ssavazzi02/tinyProbe_wius/3d_model/ASMPM-0806-2R2M-T.STEP

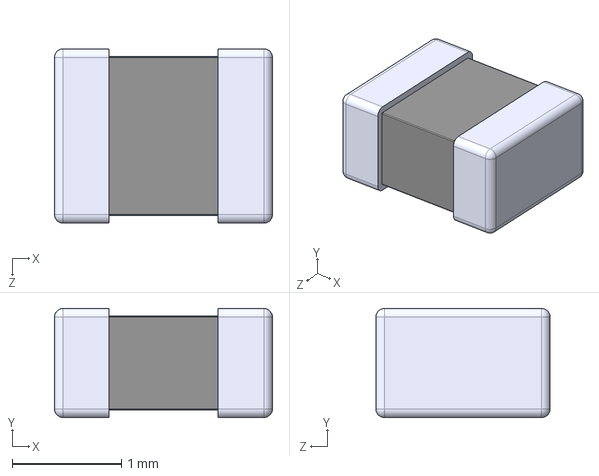
[picture p1: CAD file, 2026-06-25]
3d_model/ASMPM-0806-2R2M-T.STEP
2.00 x 1.00 x 1.60 mm
