ssavazzi02/tinyProbe_wius/3d_model/MSOP8_MC_MCH.step

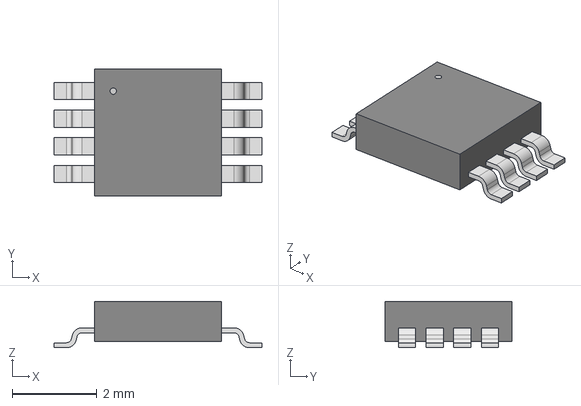
[picture p2: CAD file, 2026-08-20]
3d_model/MSOP8_MC_MCH.step
4.90 x 3.00 x 1.09 mm
