ssavazzi02/tinyProbe_wius/3d_model/ASCO-12.000MHZ-EK-T3.stp

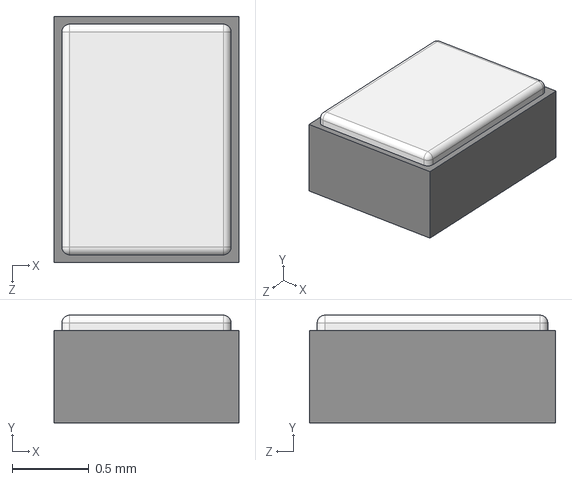
[picture p3: CAD file, 2026-08-20]
3d_model/ASCO-12.000MHZ-EK-T3.stp
1.20 x 0.7 x 1.60 mm
