ssavazzi02/tinyProbe_wius/3d_model/SIT1552AI-JE-DCC-32.768E.stp

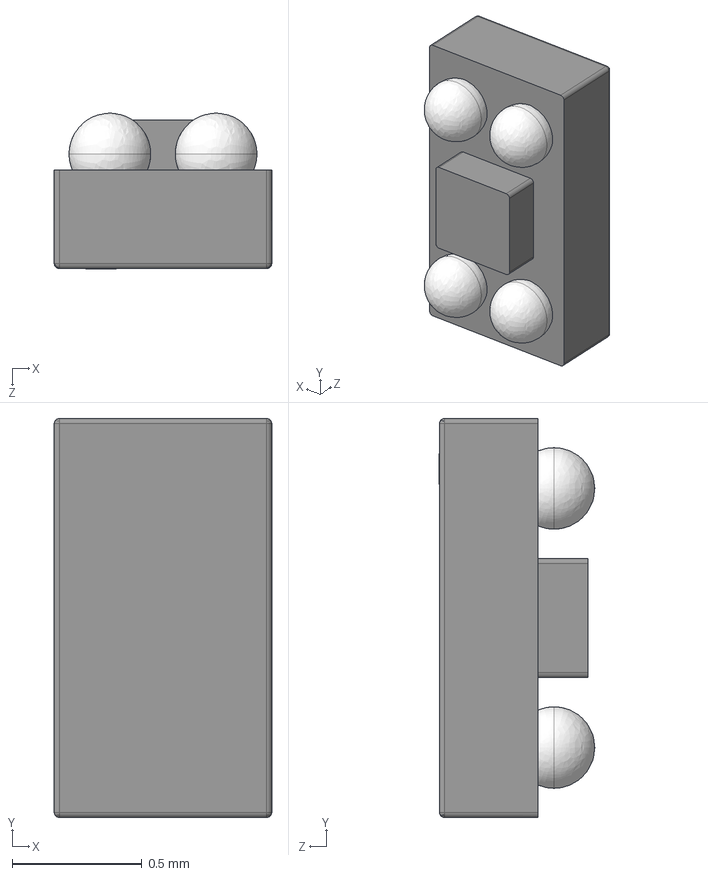
[picture p4: CAD file, 2026-06-25]
3d_model/SIT1552AI-JE-DCC-32.768E.stp
0.84 x 1.54 x 0.601 mm
Pin1_Dot
