ssavazzi02/tinyProbe_wius/3d_model/SS5-10-3.00-L-D-K-TR.stp

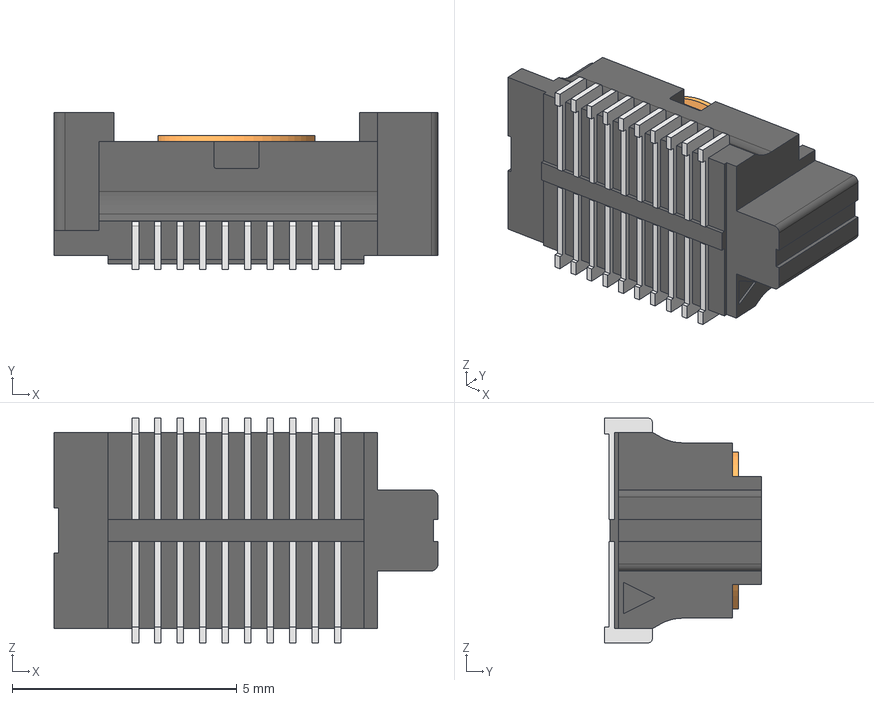
[picture p5: CAD file, 2026-06-25]
3d_model/SS5-10-3.00-L-D-K-TR.stp
8.54 x 3.50 x 5.00 mm
SS5-10_socket
C-229-10-3.00_
C-229-10-3.00-2_
K-DOT-.138-.250-.005_polyamide_pick_
