ssavazzi02/tinyProbe_wius/3d_model/SM02B-SURS-TF (LF)(SN)--3DModel-STEP-510211.STEP

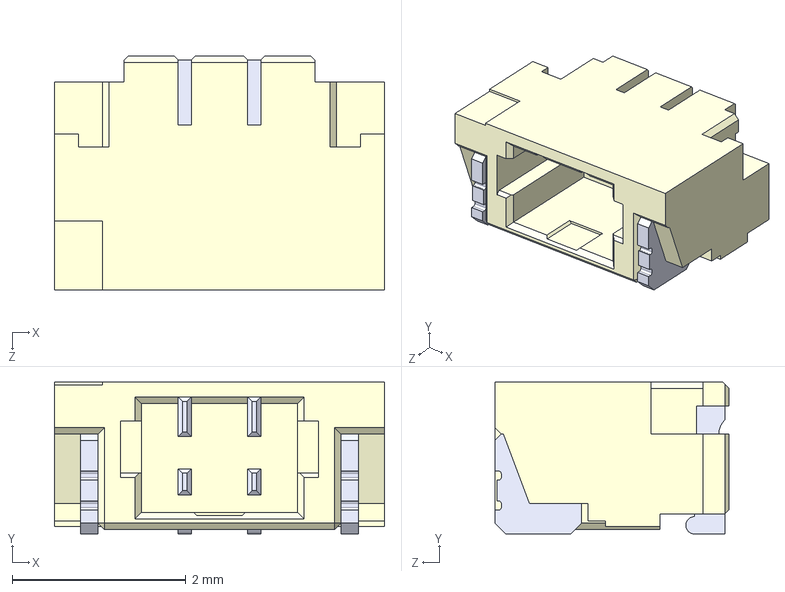
[picture p6: CAD file, 2026-06-25]
3d_model/SM02B-SURS-TF (LF)(SN)--3DModel-STEP-510211.STEP
3.80 x 1.75 x 2.70 mm
