ssavazzi02/tinyProbe_wius/3d_model/XTAL_KC2016K32_7680C1GE00_KAV.step

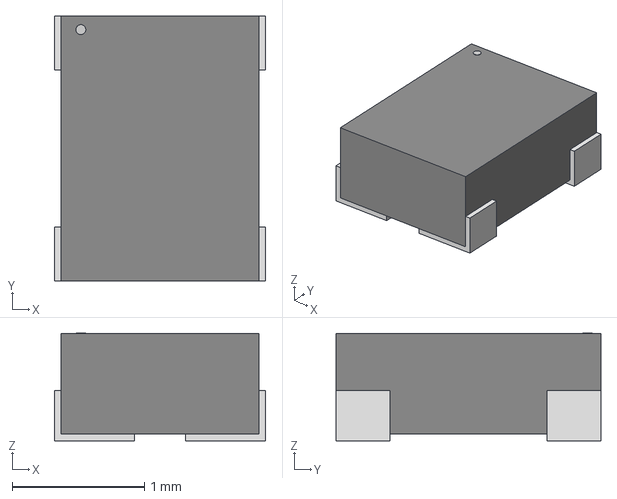
[picture p7: CAD file, 2026-06-25]
3d_model/XTAL_KC2016K32_7680C1GE00_KAV.step
1.60 x 2.01 x 0.815 mm
