ssavazzi02/tinyProbe_wius/3d_model/SIWG917Y111MGABAR.stp

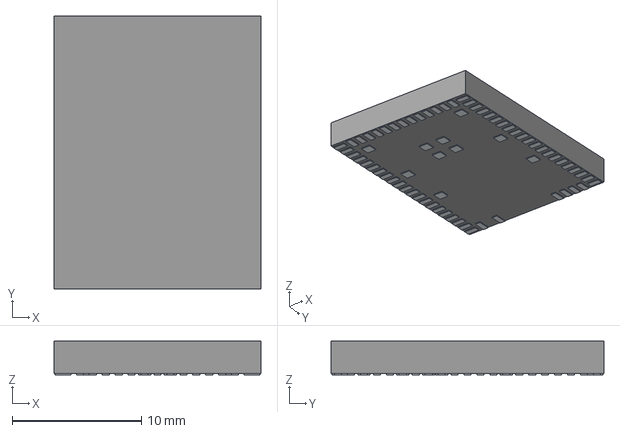
[picture p8: CAD file, 2026-06-25]
3d_model/SIWG917Y111MGABAR.stp
16.0 x 21.1 x 2.60 mm
Pins
