ssavazzi02/tinyProbe_wius/3d_model/QFN-56_FT232HPQ_FTD.step

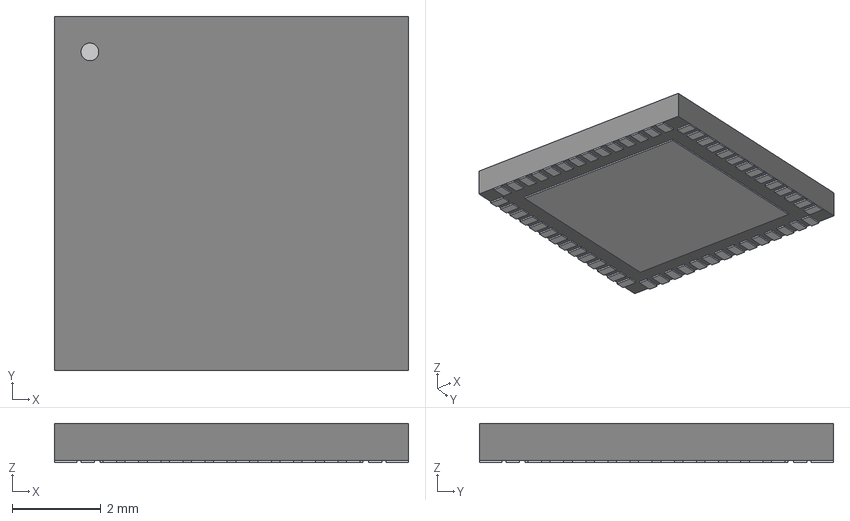
[picture p9: CAD file, 2026-06-25]
3d_model/QFN-56_FT232HPQ_FTD.step
8.00 x 8.00 x 0.892 mm
