ssavazzi02/tinyProbe_wius/3d_model/PCAL6408AHKX.stp

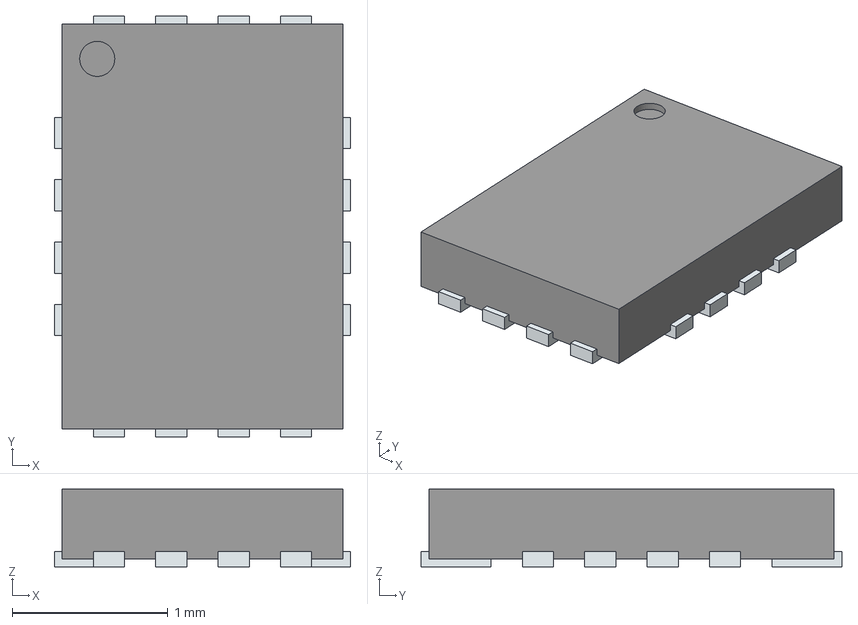
[picture p10: CAD file, 2026-06-11]
3d_model/PCAL6408AHKX.stp
1.90 x 2.70 x 0.5 mm
PinsArrayLR
PinsArrayTB
