ssavazzi02/tinyProbe_wius/3d_model/104031-0811.stp

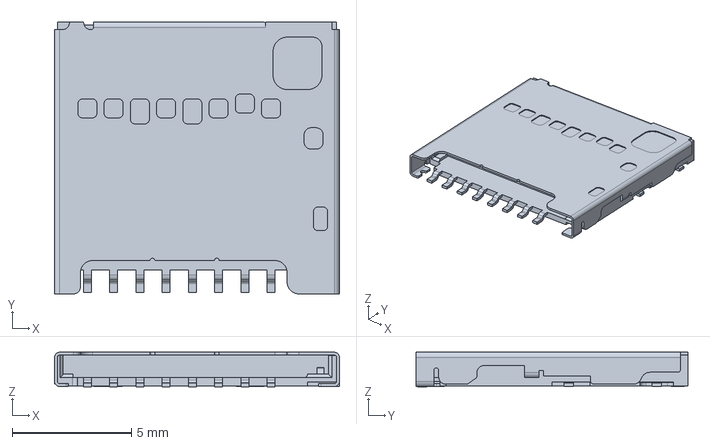
[picture p11: CAD file, 2026-06-25]
3d_model/104031-0811.stp
11.9 x 11.4 x 1.45 mm
