ssavazzi02/tinyProbe_wius/3d_model/TPS62840YBGR--3DModel-STEP-56544.STEP

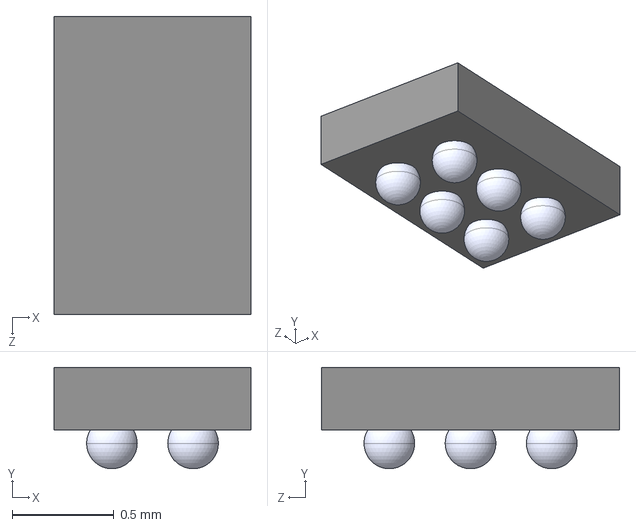
[picture p12: CAD file, 2026-06-25]
3d_model/TPS62840YBGR--3DModel-STEP-56544.STEP
0.968 x 0.5 x 1.47 mm
