ssavazzi02/tinyProbe_wius/3d_model/BQ24040DSQT.stp

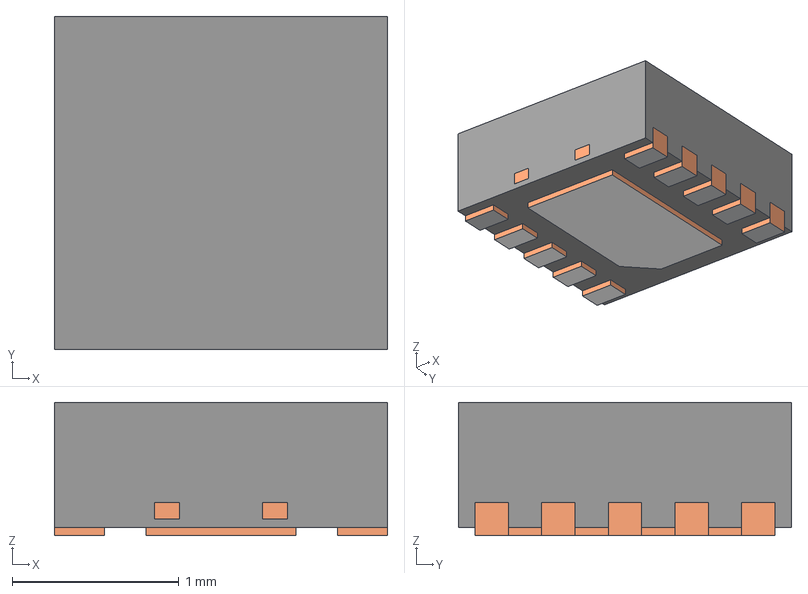
[picture p13: CAD file, 2026-06-25]
3d_model/BQ24040DSQT.stp
2.00 x 2.00 x 0.8 mm
BODY-SON
FRAME-DSQ0010A
PIN1-ID
