ssavazzi02/tinyProbe_wius/3d_model/5051100892.stp

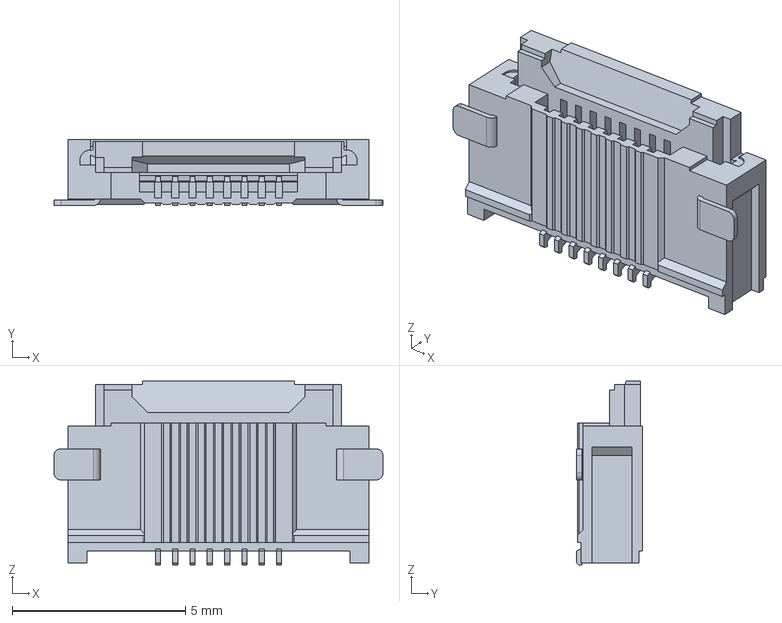
[picture p14: CAD file, 2026-06-25]
3d_model/5051100892.stp
9.50 x 1.90 x 5.30 mm
