ssavazzi02/tinyProbe_wius/3d_model/52746-1271.stp

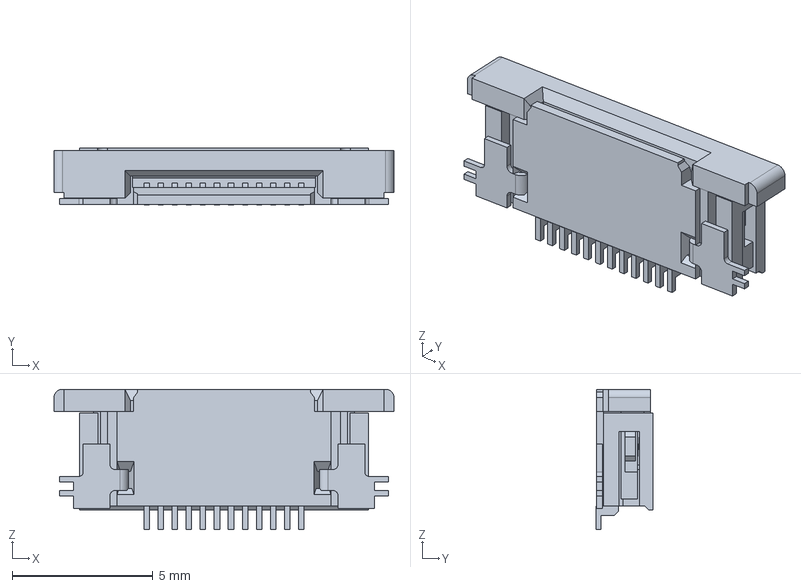
[picture p15: CAD file, 2026-06-25]
3d_model/52746-1271.stp
12.1 x 2.02 x 5.00 mm
