ssavazzi02/tinyProbe_wius/wius_new.pdf

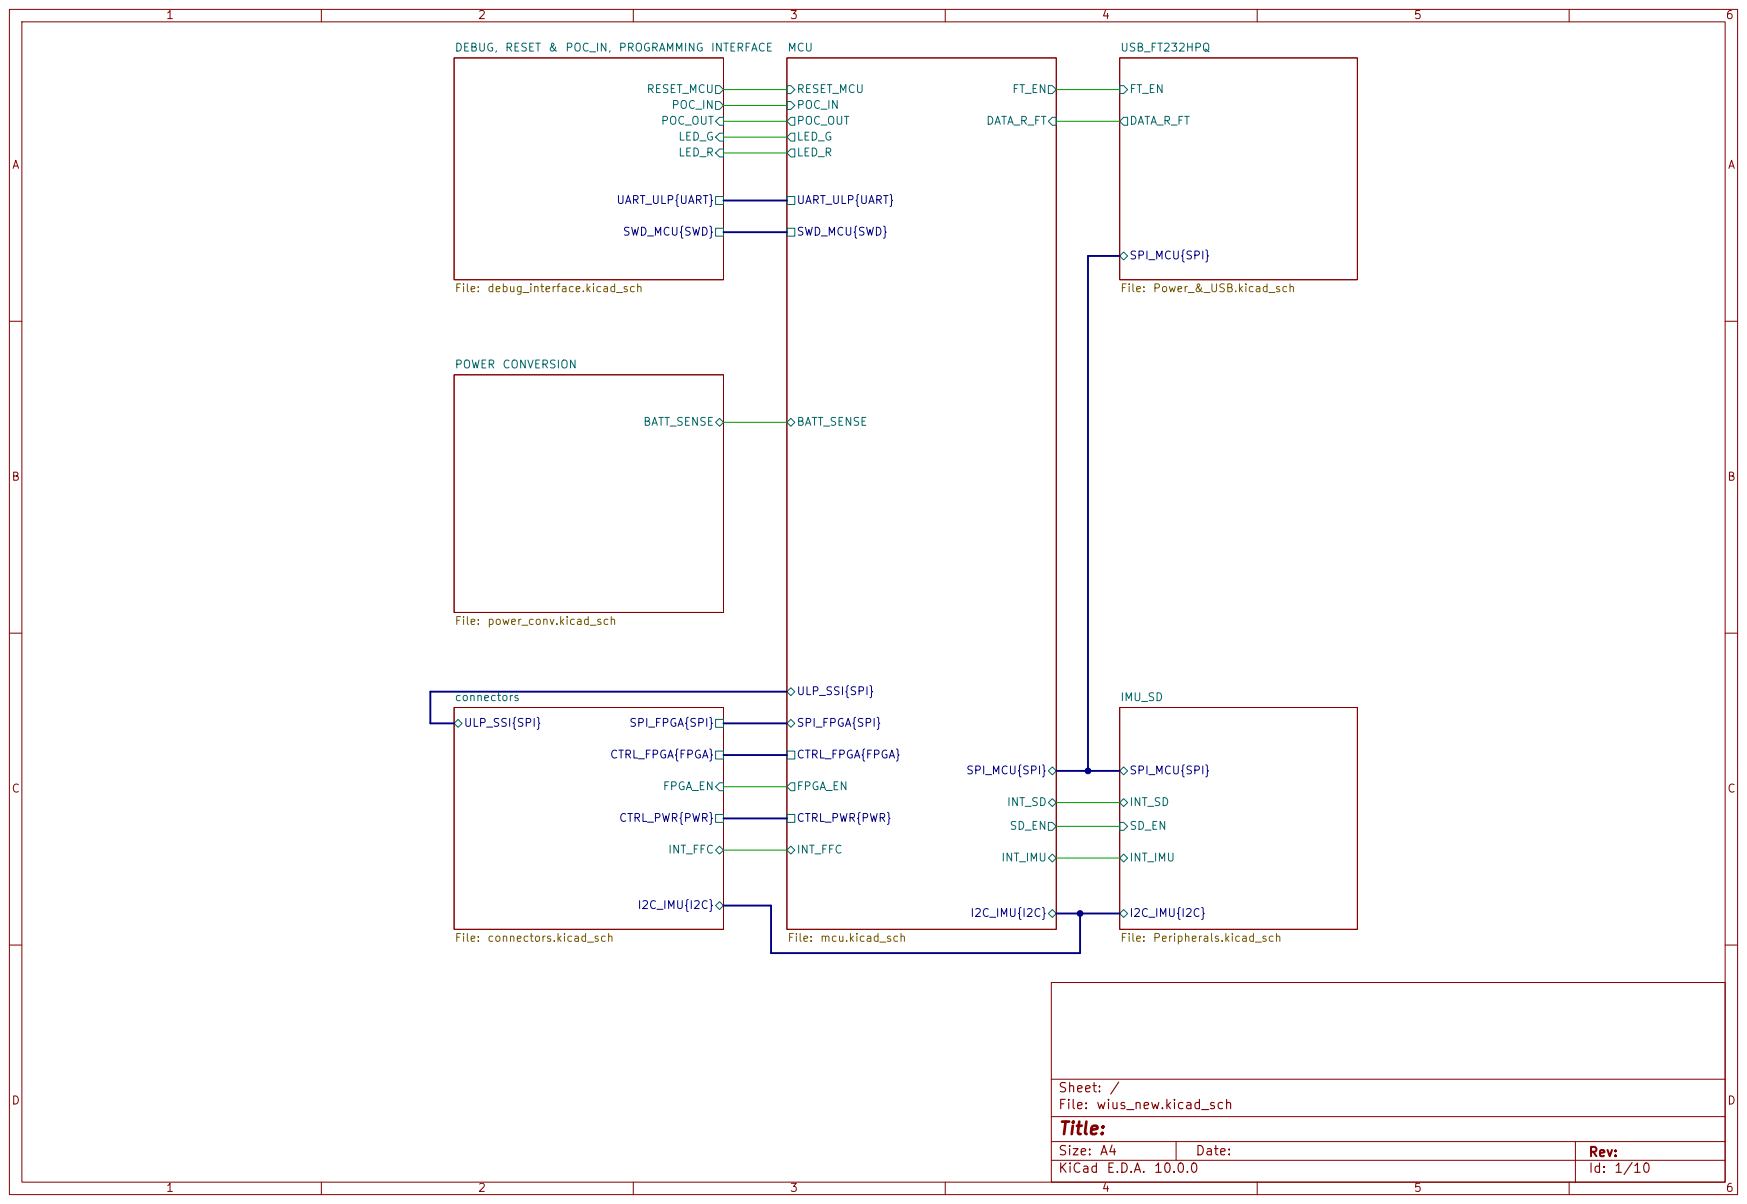
[picture p16: page 1]

DEBUG, RESET & POC_IN, PROGRAMMING INTERFACE

Size: A4 | Rev:
KiCad E.D.A. 10.0.0 | Id: 1/10

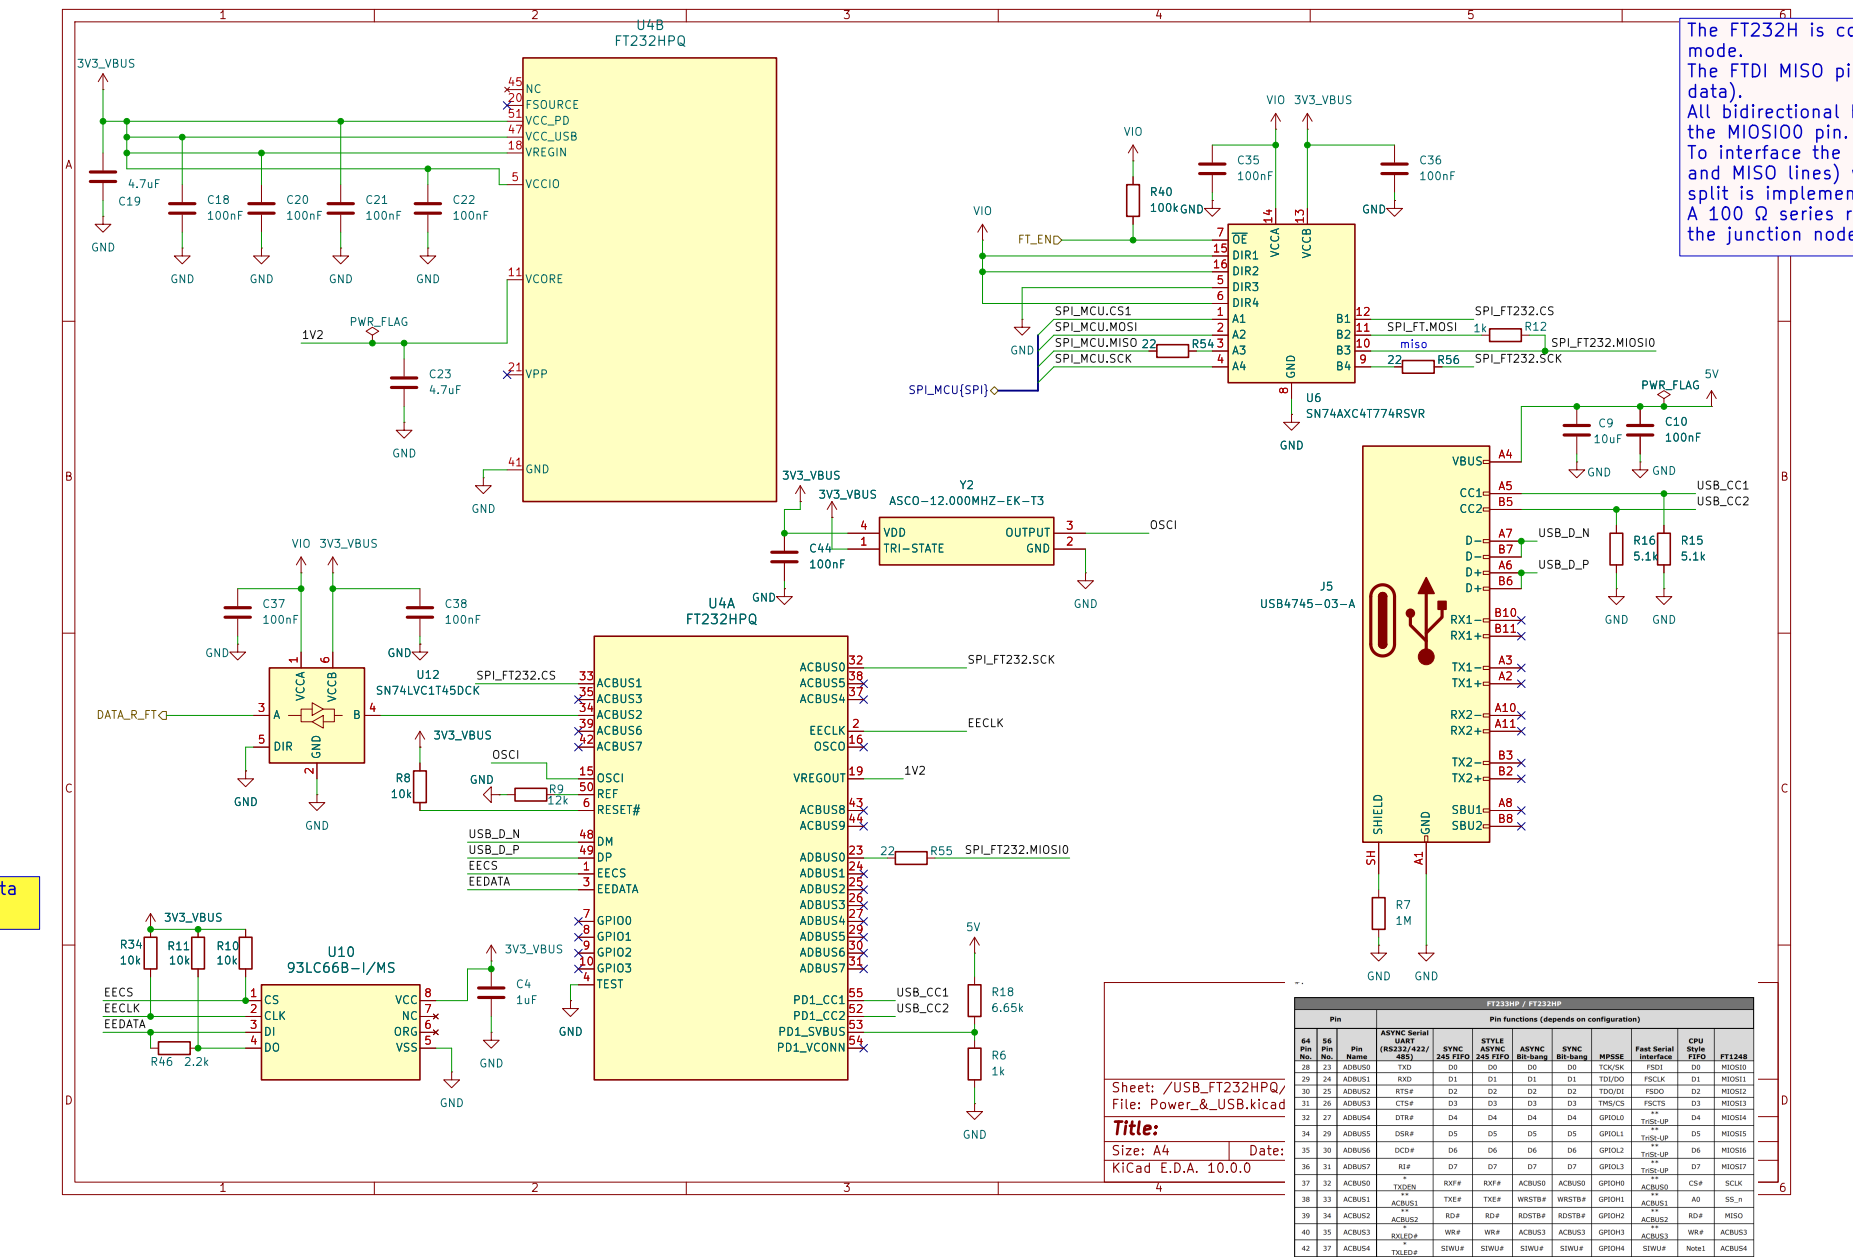
[picture p17: page 2]

mode.
The FTDI MISO pin is not used in this mode (jsut for state
data).
All bidirectional half-duplex data traffic is carried over
the MIOSIO0 pin.
To interface the MCU's standard SPI bus (separate MOSI
and MISO lines) with the single MIOSIO0 pin, the signal
split is implemented on the 3.3 V side (TXB0104 output).
A 100 Ω series resistor is placed on the MOSI line before
the junction node with MISO.

VREGIN 18

VCCIO 5

ATTACH ACBUS5 to MCU for "data

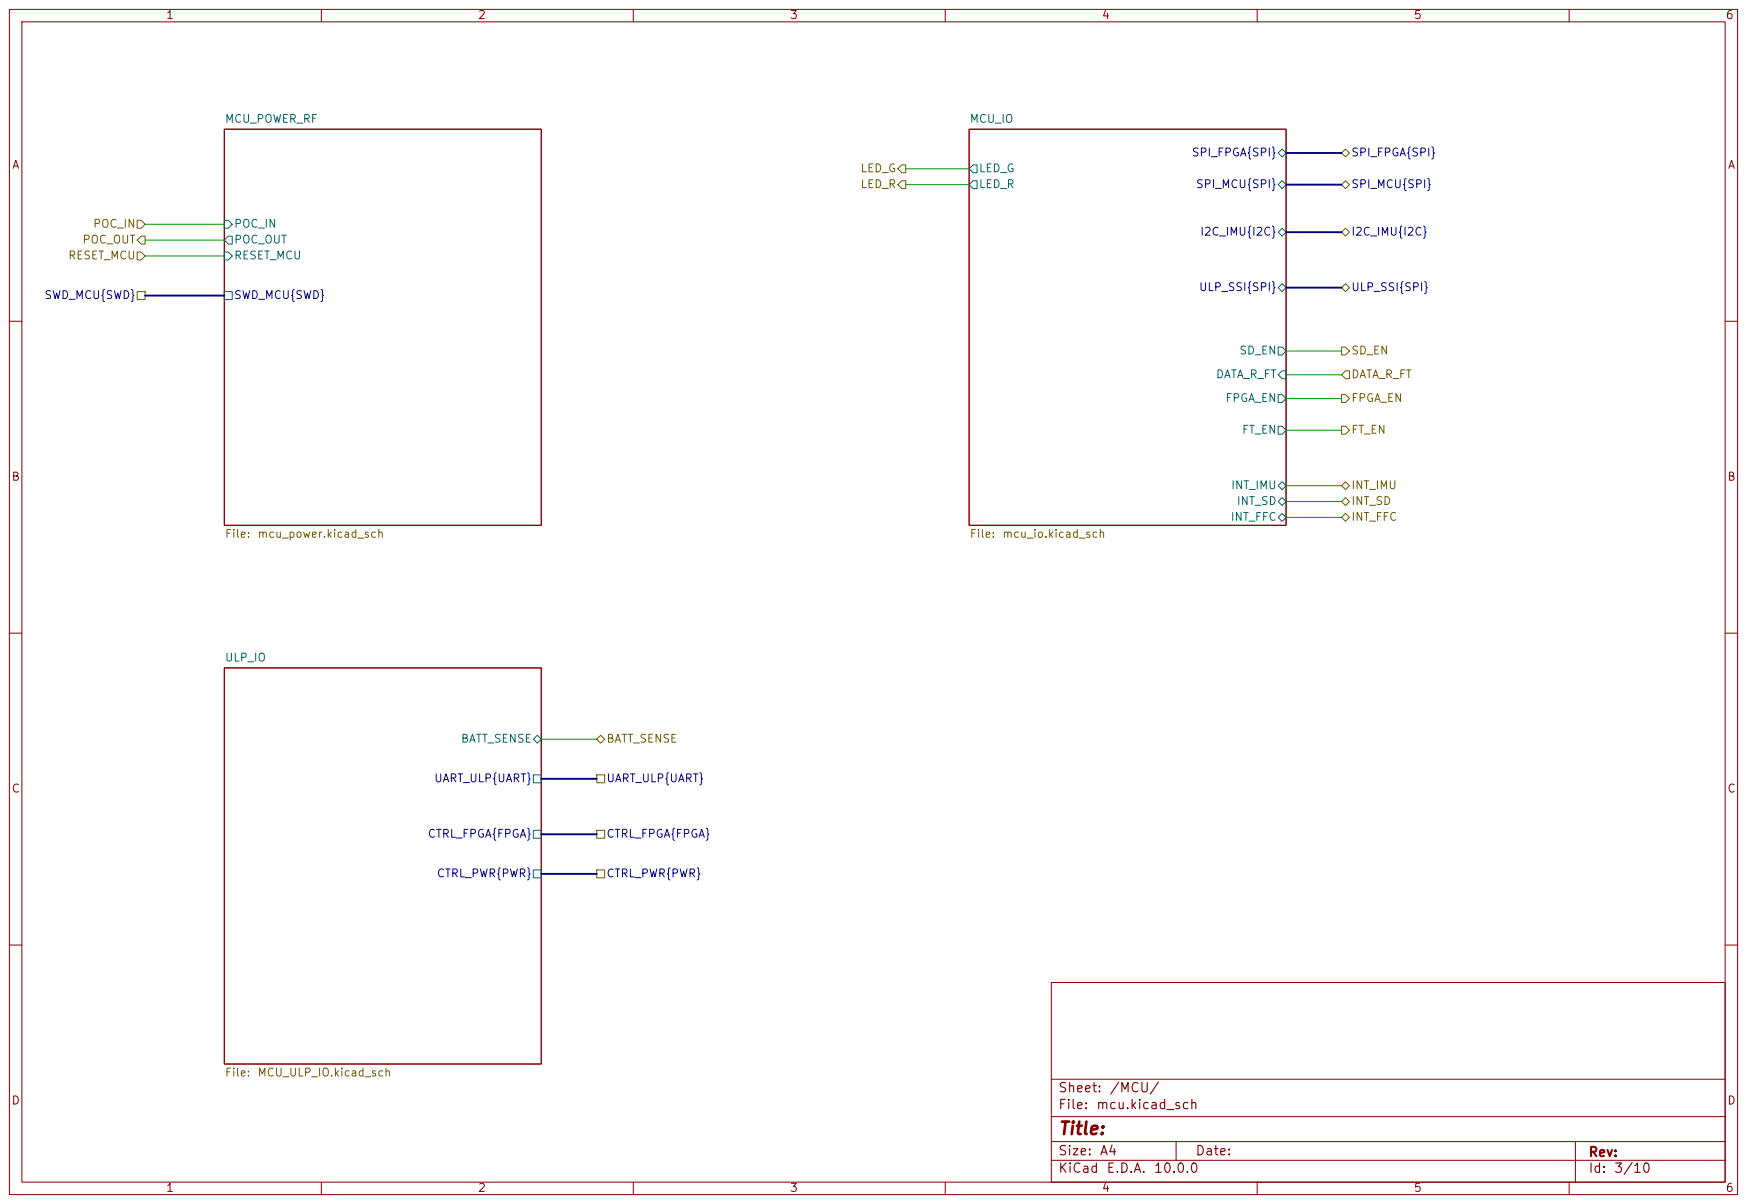
[picture p18: page 3]

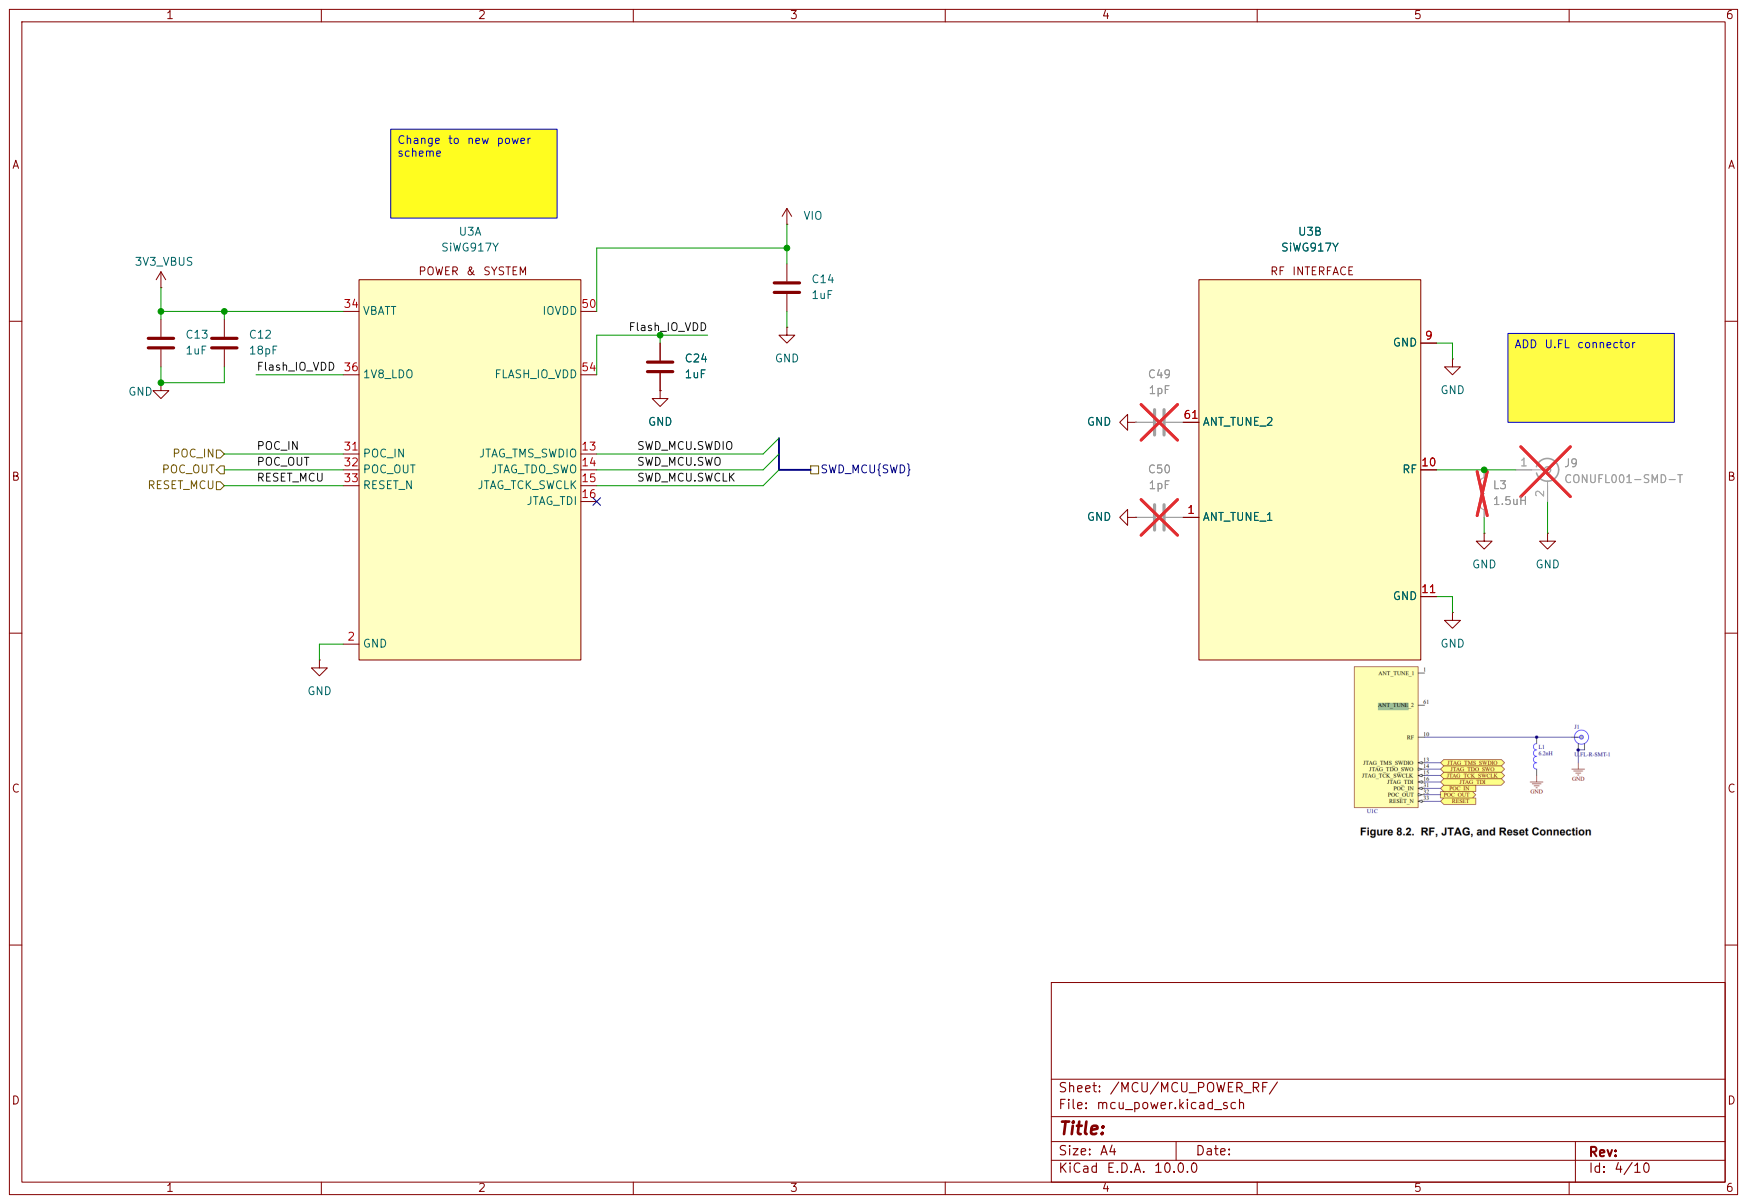
[picture p19: page 4]

ADD U.FL connector Change to new power scheme

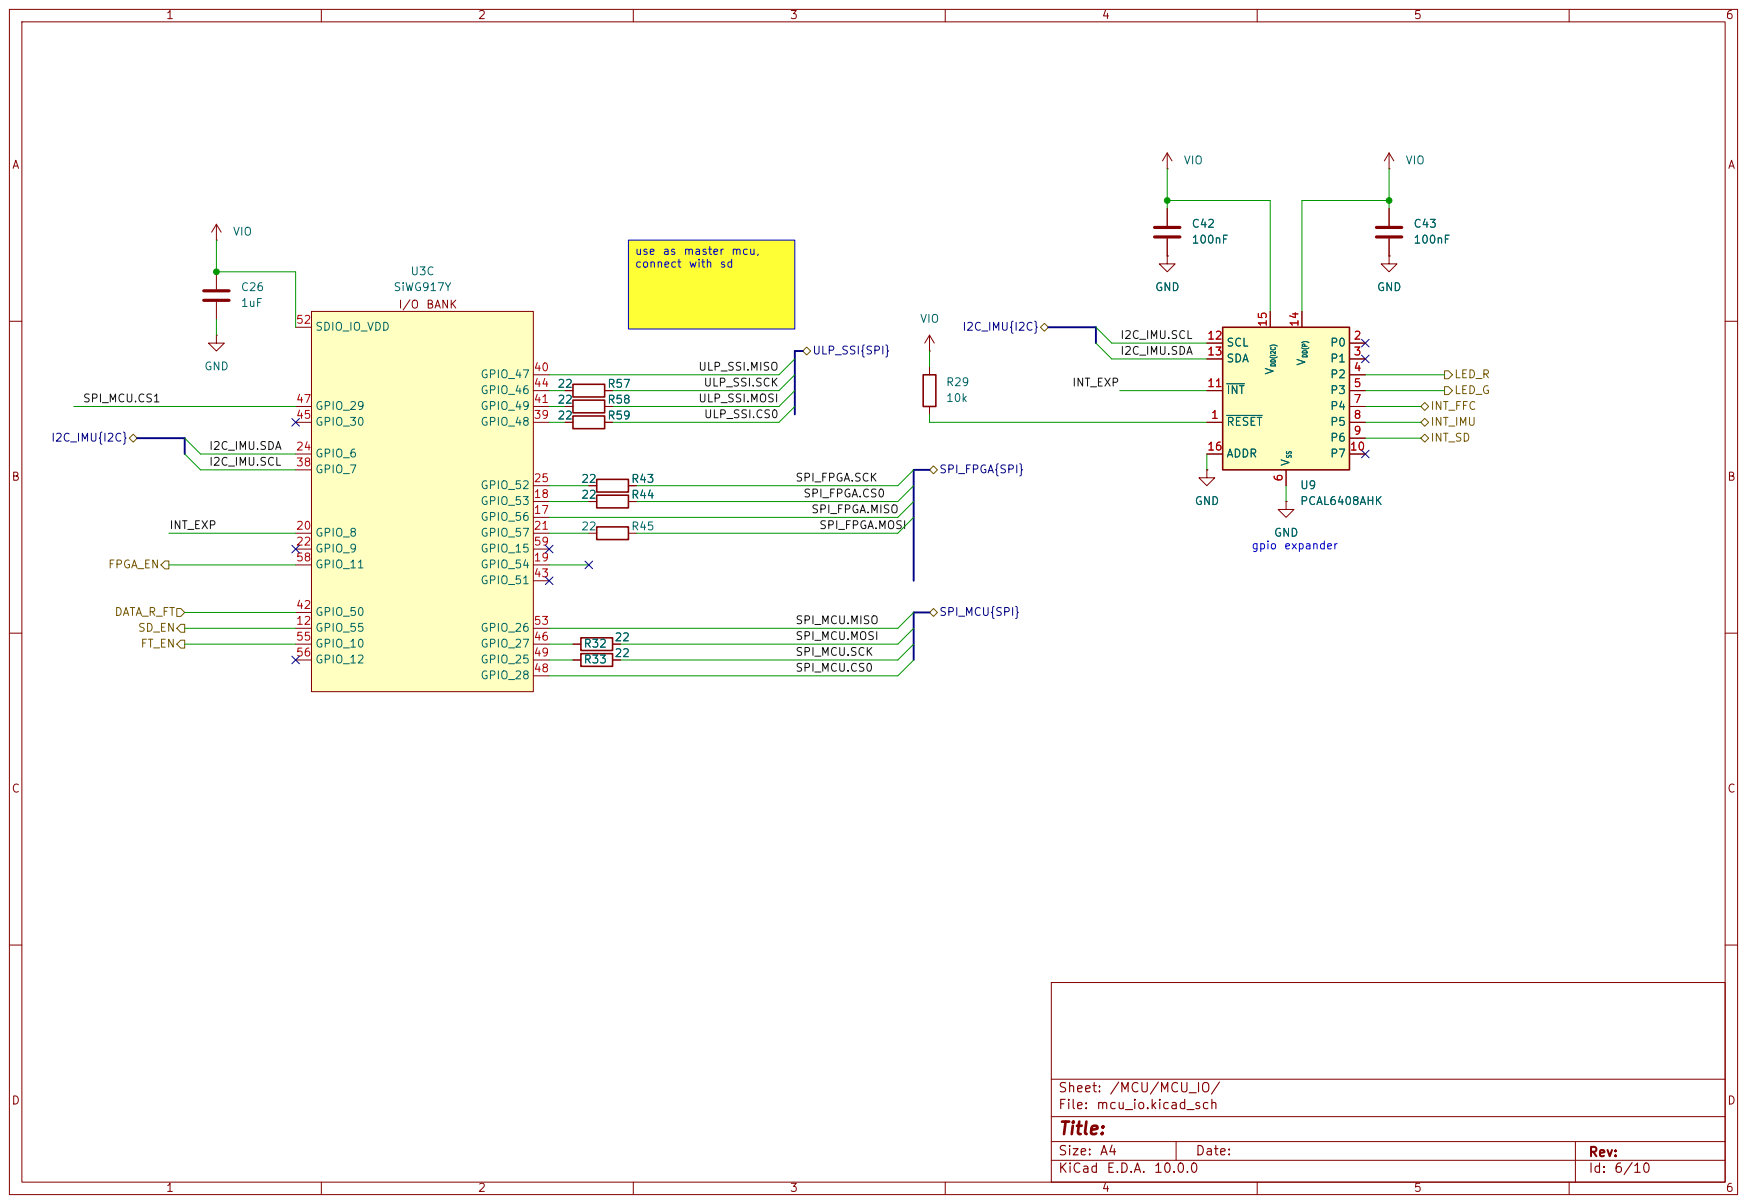
[picture p20: page 5]

SPI_MCU.MOSI use as master mcu, connect with sd

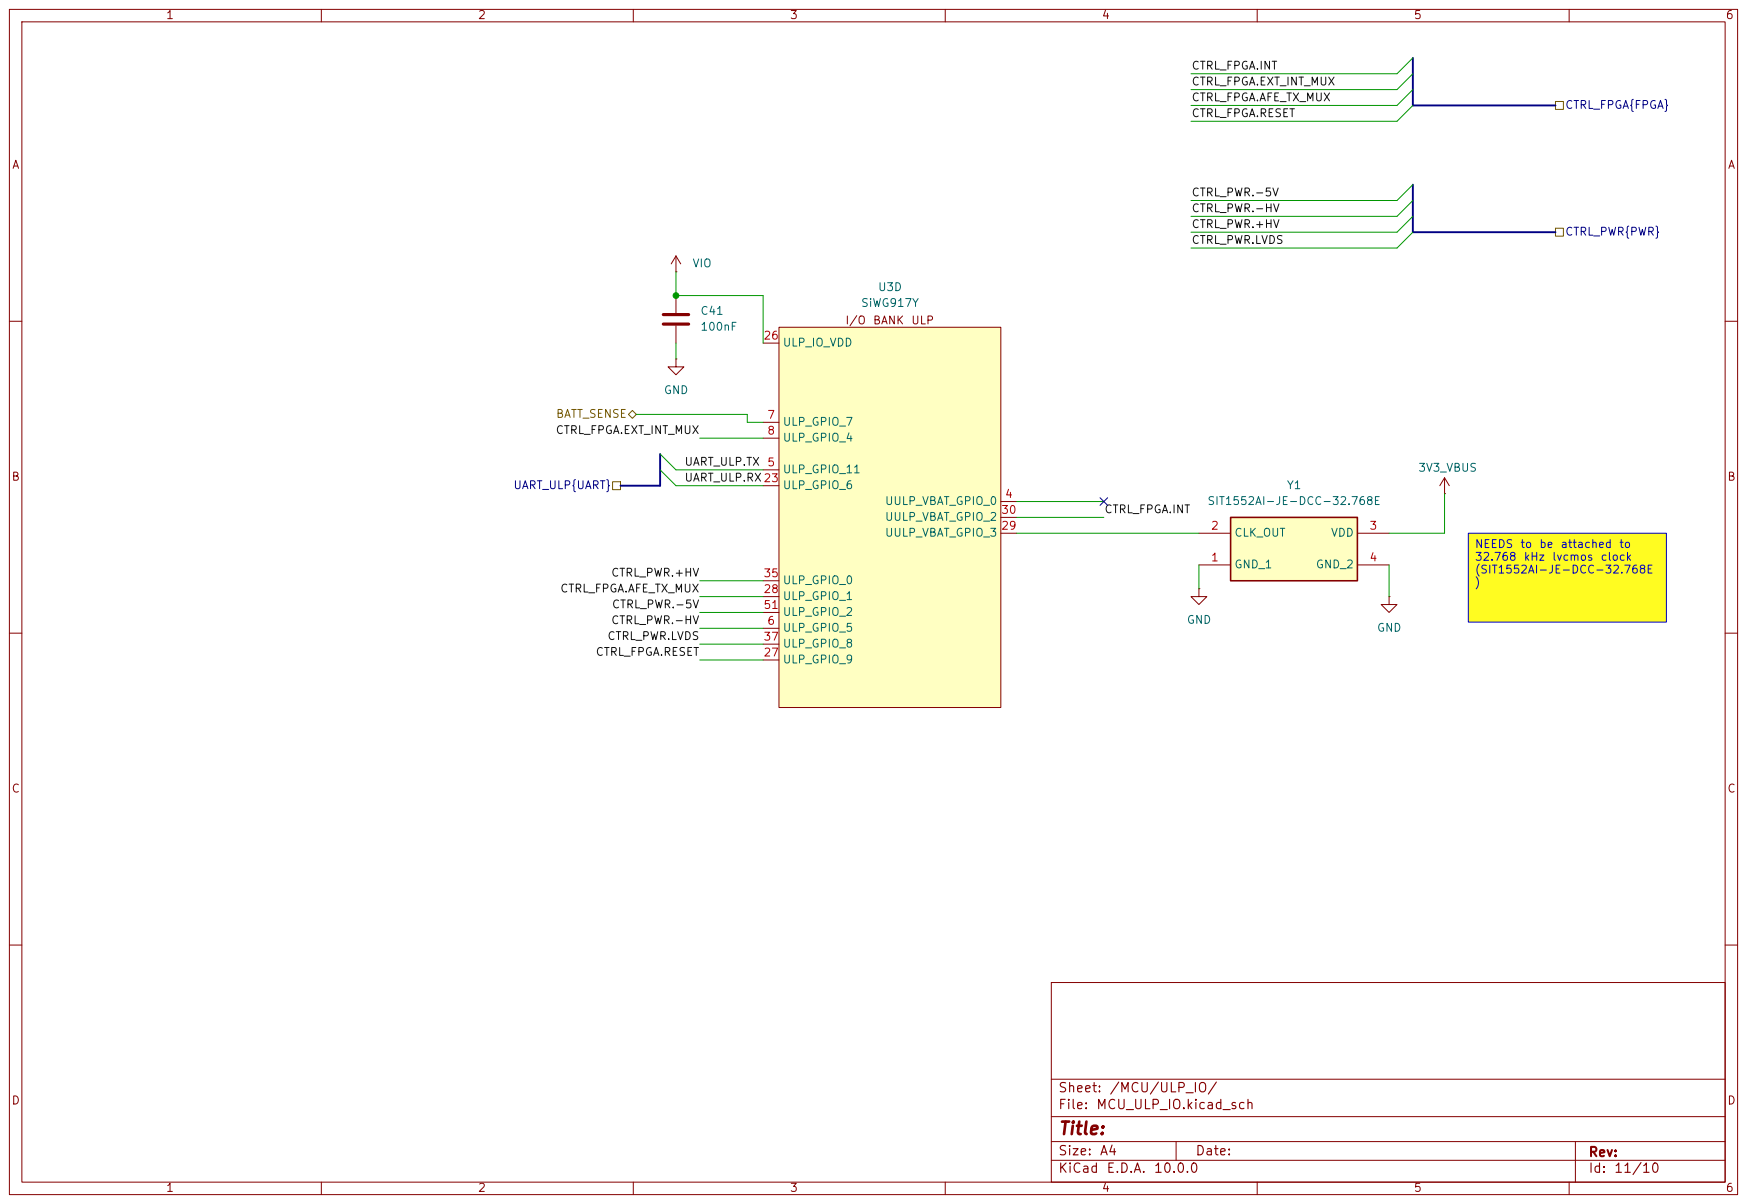
[picture p21: page 6]

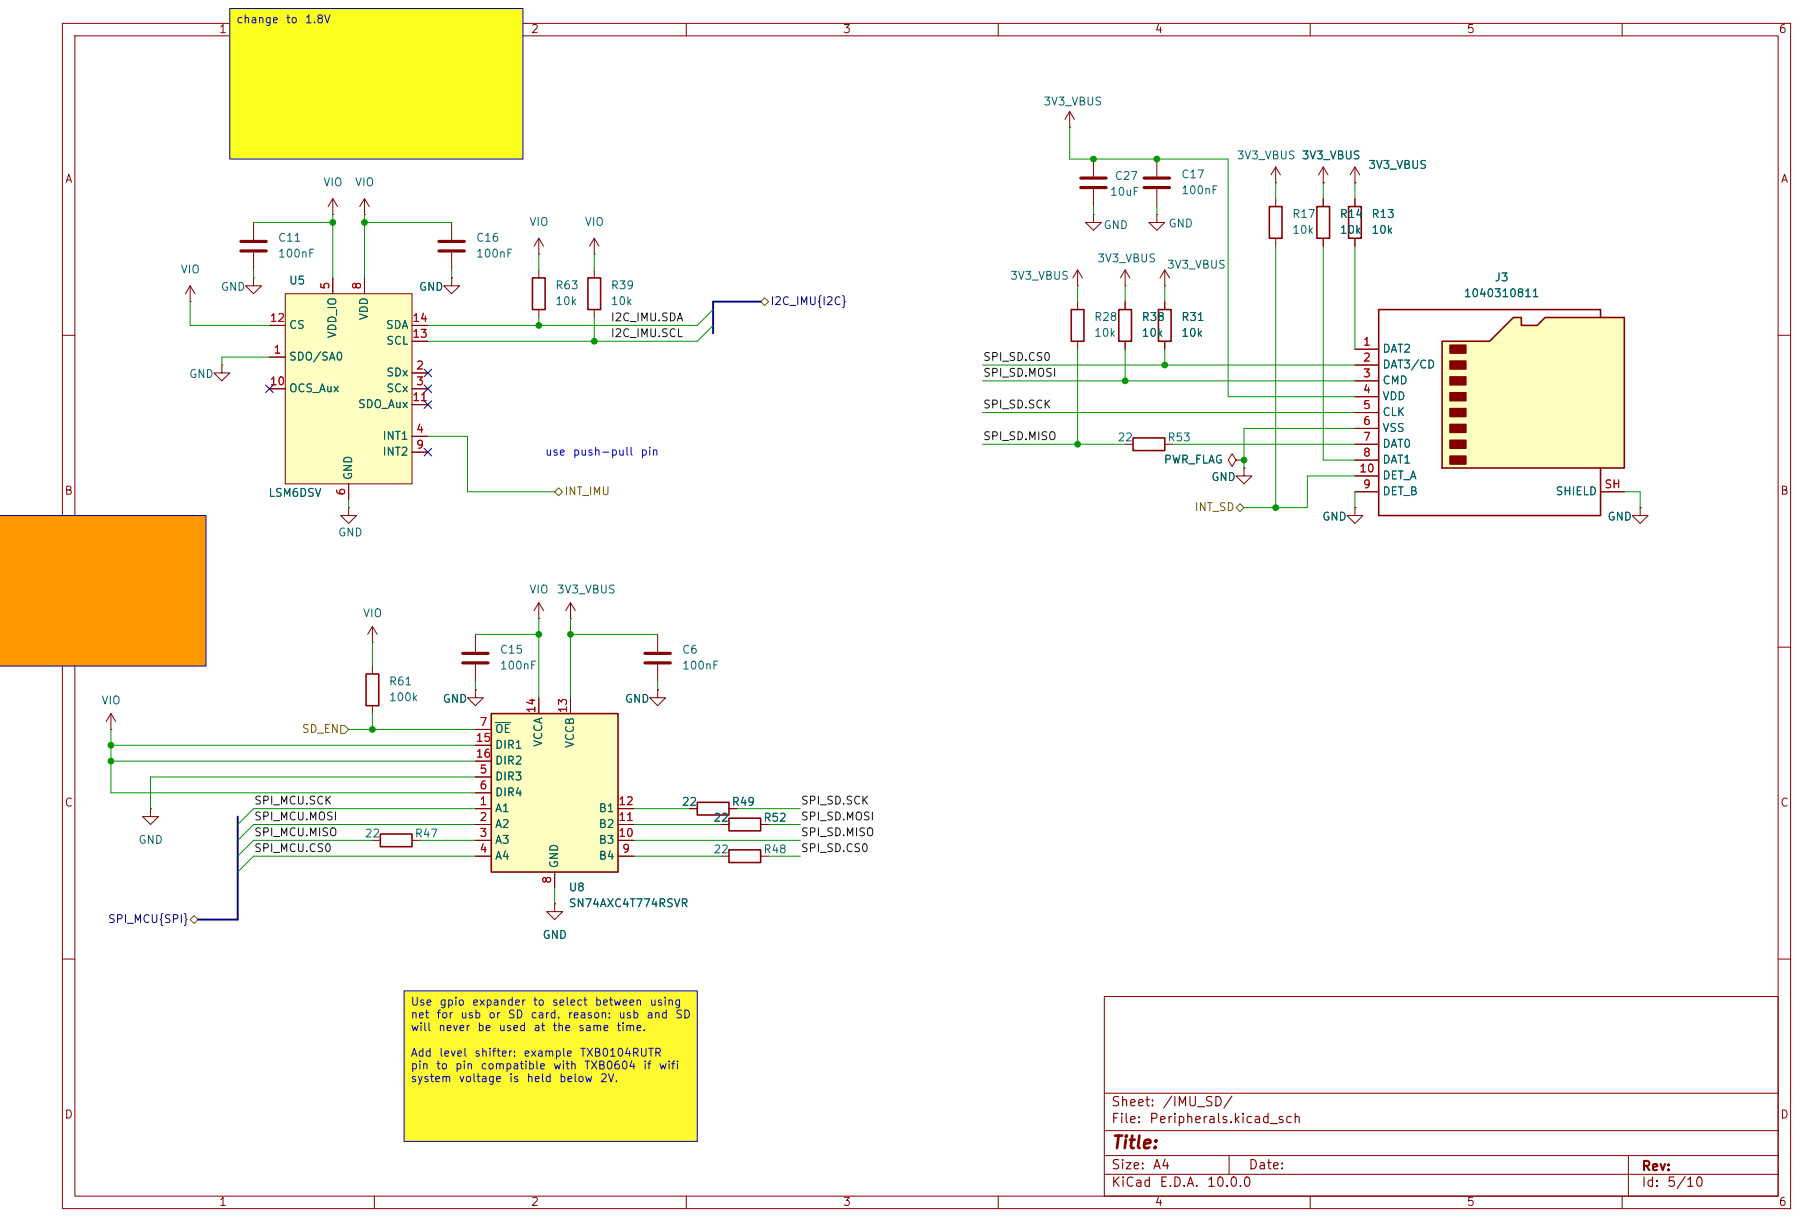
[picture p22: page 7]

Use gpio expander to select between using
net for usb or SD card. reason: usb and SD will never be used at the same time. Add level shifter: example TXB0104RUTR

pin to pin compatible with TXB0604 if wifi system voltage is held below 2V.

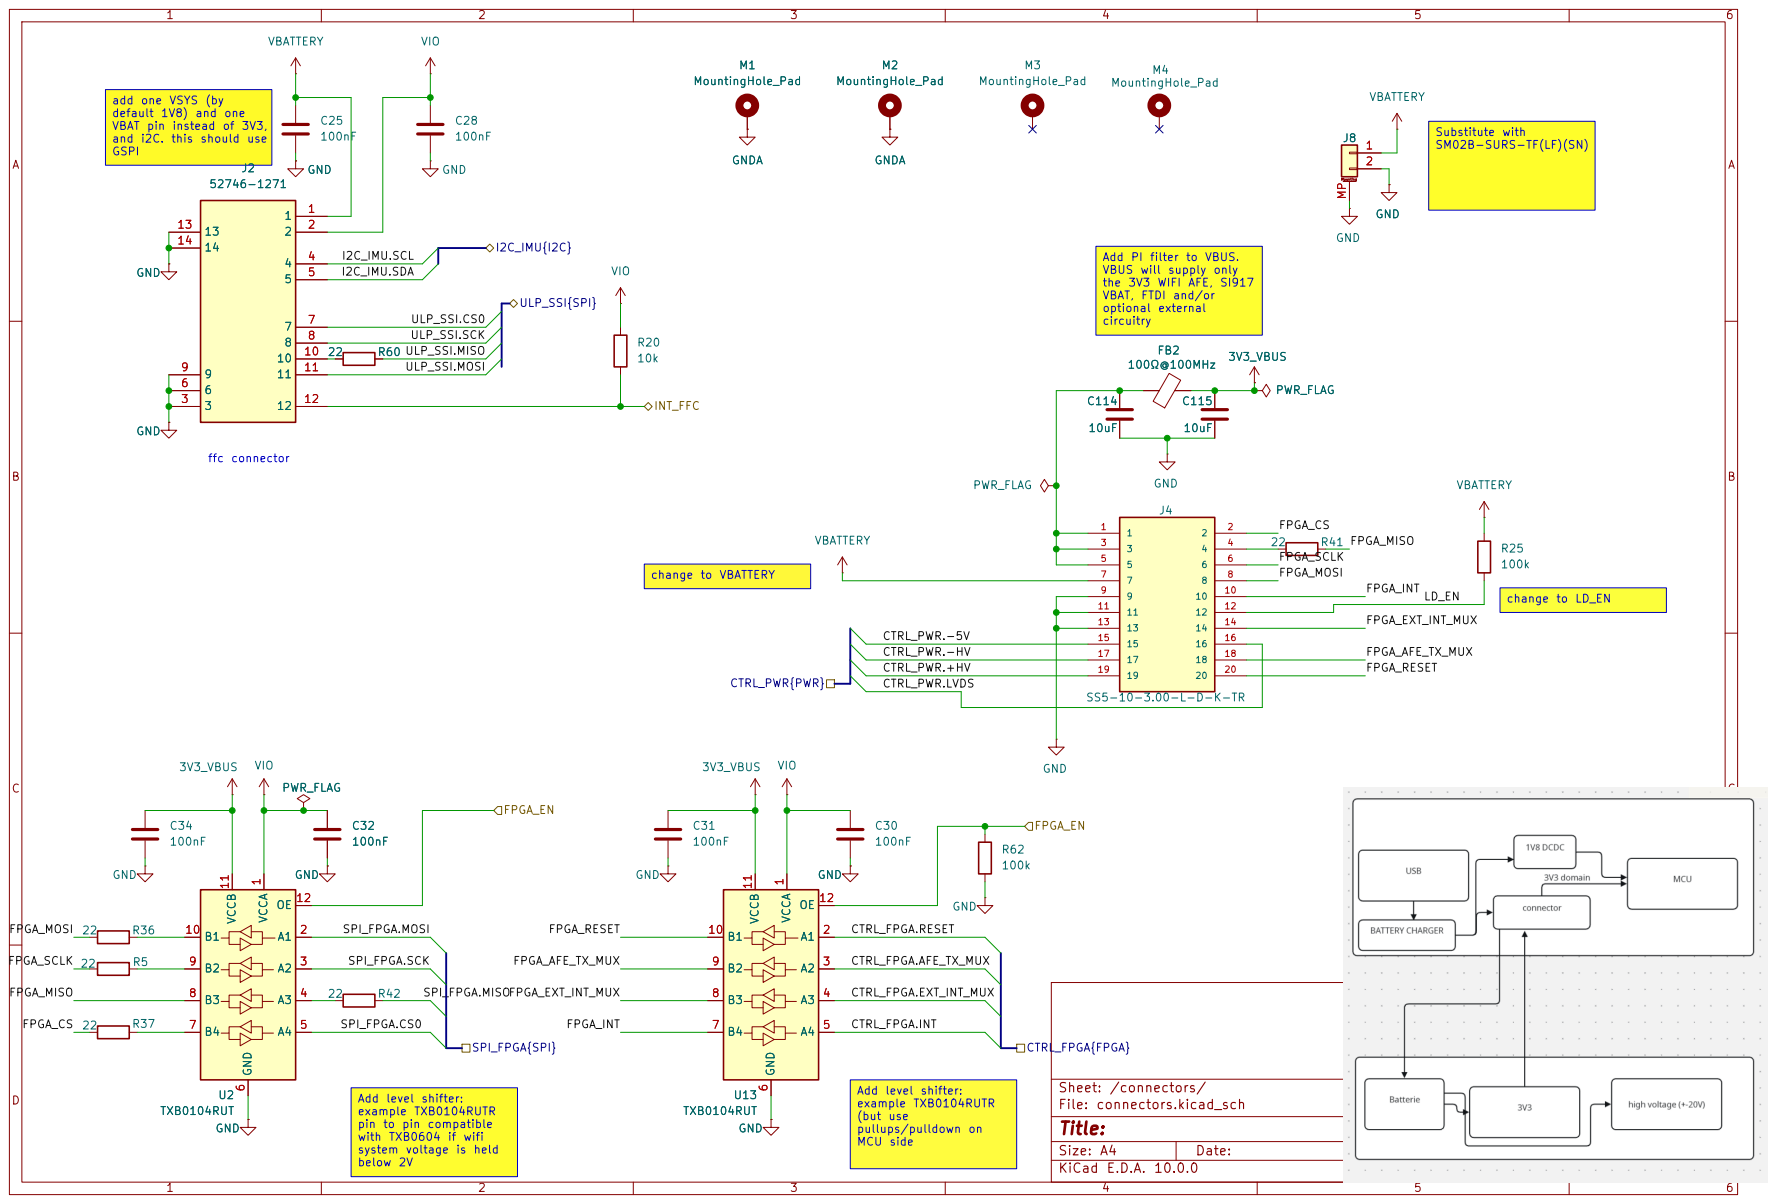
[picture p23: page 8]

add one VSYS (by
default 1V8) and one

Substitute with SM02B-SURS-TF(LF)(SN)

the 3V3 WIFI AFE, SI917
VBAT, FTDI and/or
optional external circuitry

Add level shifter: example TXB0104RUTR

(but use pullups/pulldown on MCU side

pin to pin compatible
with TXB0604 if wifi system voltage is held

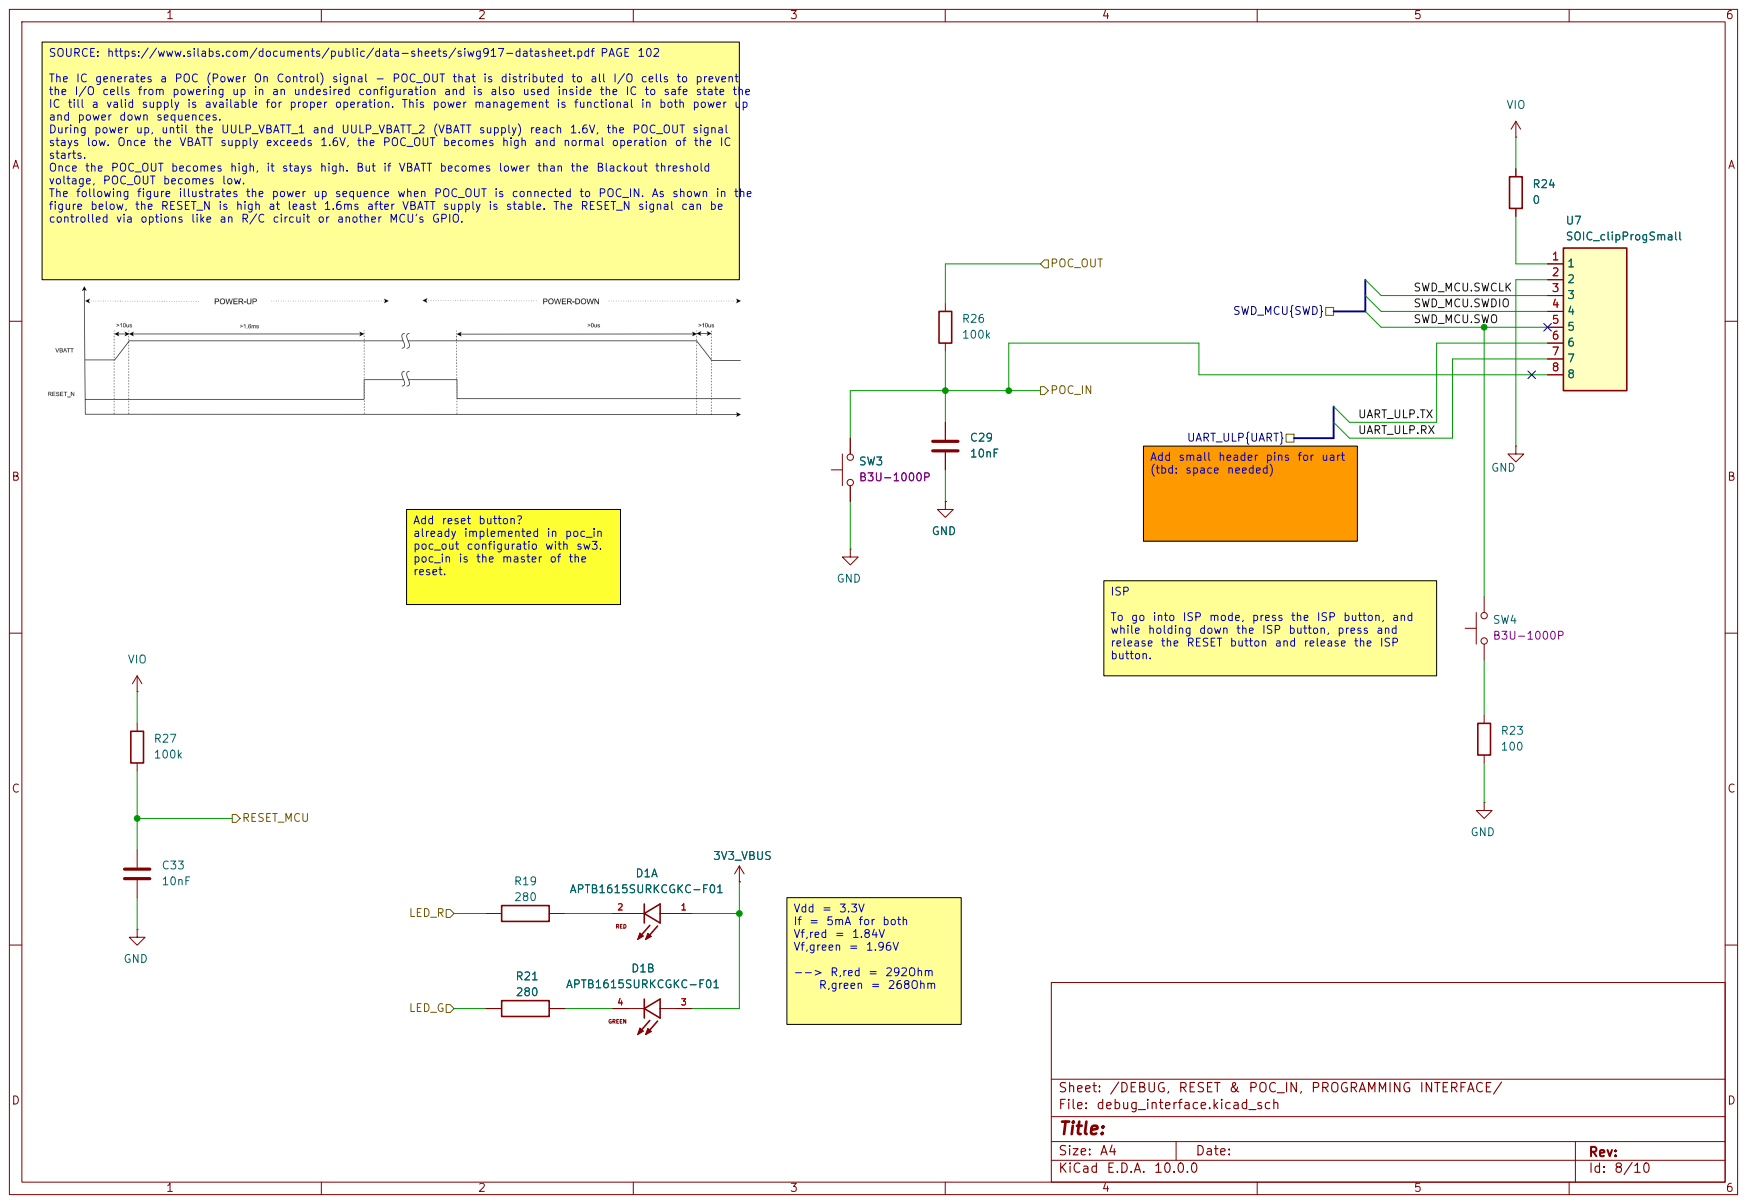
[picture p24: page 9]

SOURCE: https://www.silabs.com/documents/public/data-sheets/siwg917-datasheet.pdf PAGE 102

The IC generates a POC (Power On Control) signal - POC_OUT that is distributed to all I/O cells to prevent
the I/O cells from powering up in an undesired configuration and is also used inside the IC to safe state the
IC till a valid supply is available for proper operation. This power management is functional in both power up
and power down sequences. During power up, until the UULP_VBATT_1 and UULP_VBATT_2 (VBATT supply) reach 1.6V, the POC_OUT signal

stays low. Once the VBATT supply exceeds 1.6V, the POC_OUT becomes high and normal operation of the IC
starts. Once the POC_OUT becomes high, it stays high. But if VBATT becomes lower than the Blackout threshold

voltage, POC_OUT becomes low. The following figure illustrates the power up sequence when POC_OUT is connected to POC_IN. As shown in the

figure below, the RESET_N is high at least 1.6ms after VBATT supply is stable. The RESET_N signal can be
controlled via options like an R/C circuit or another MCU's GPIO.

Add reset button? already implemented in poc_in

poc_out configuratio with sw3. poc_in is the master of the

To go into ISP mode, press the ISP button, and while holding down the ISP button, press and

release the RESET button and release the ISP

Sheet: /DEBUG, RESET & POC_IN, PROGRAMMING INTERFACE/
File: debug_interface.kicad_sch
Title:

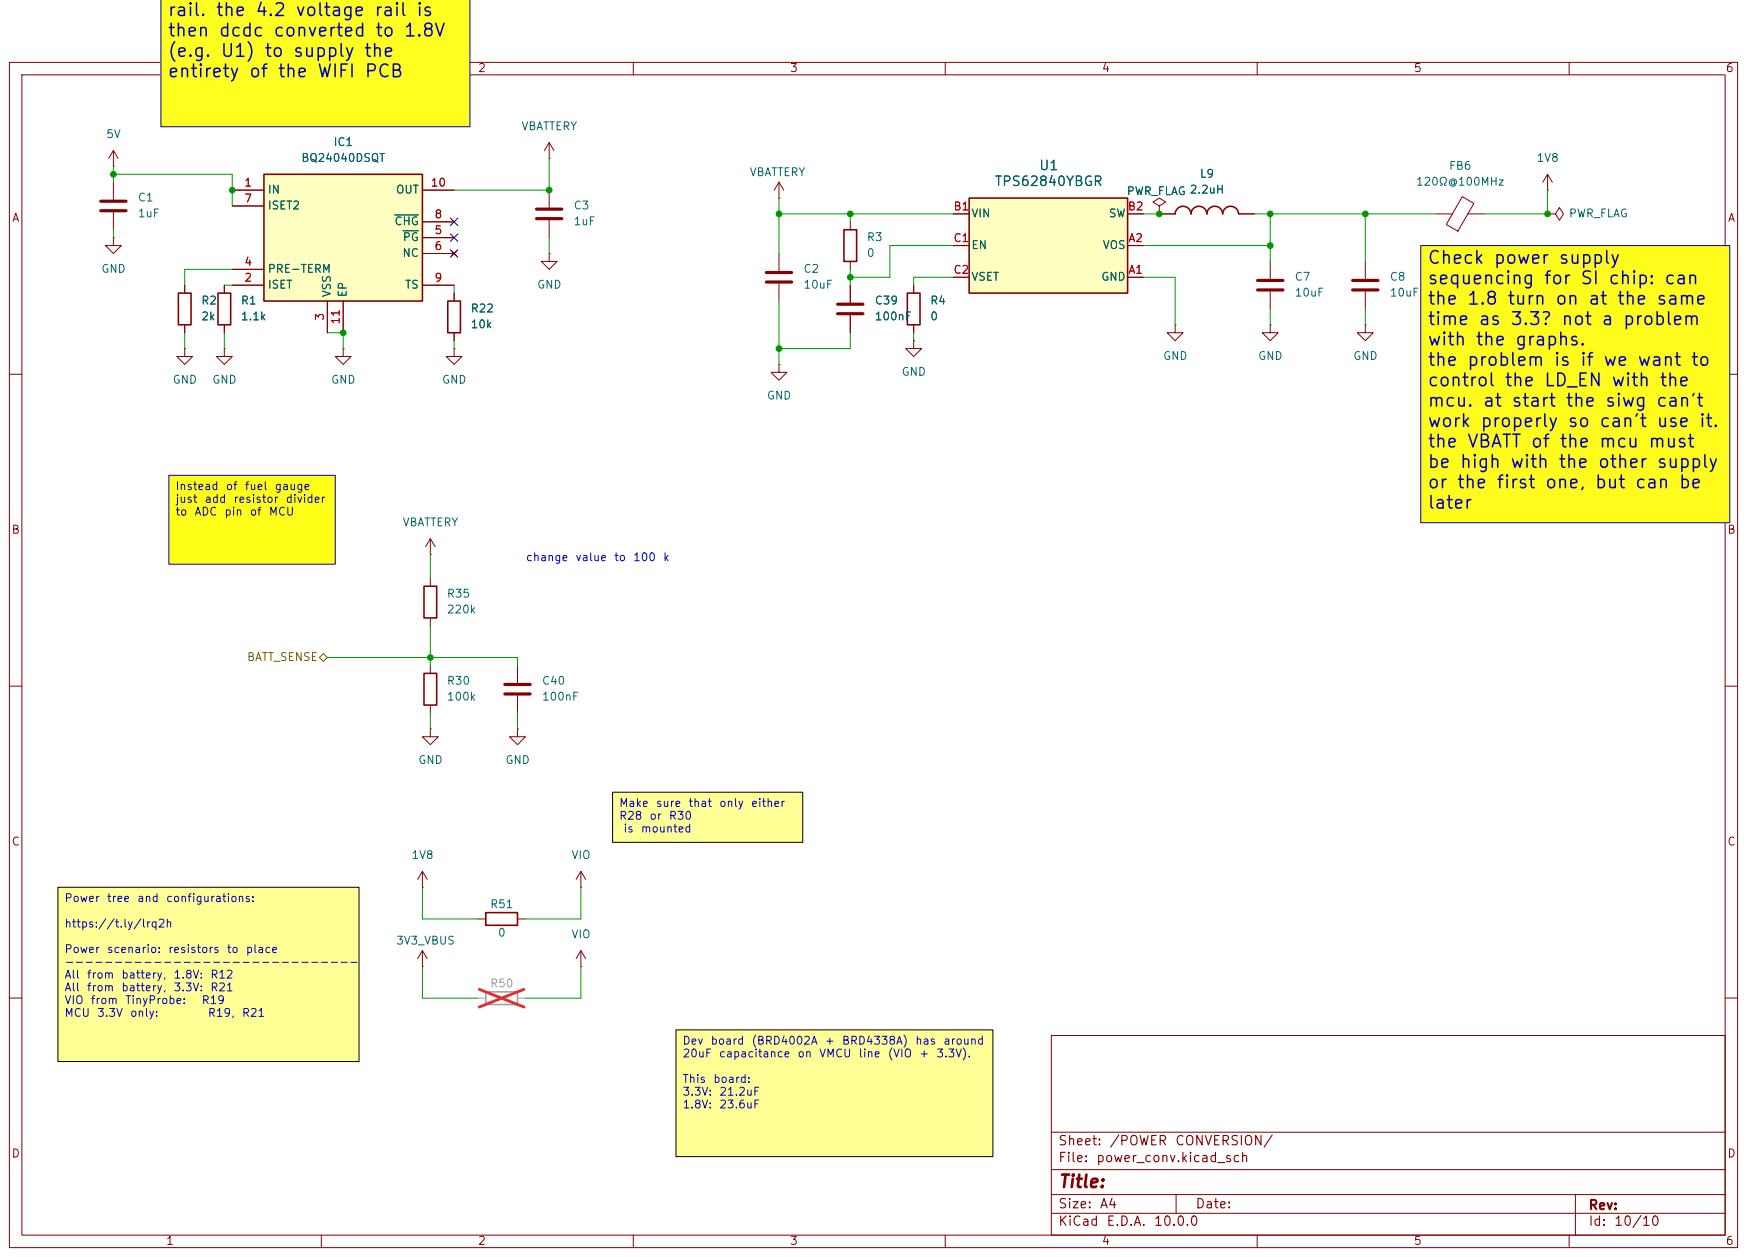
[picture p25: page 10]

rail. the 4.2 voltage rail is
then dcdc converted to 1.8V
(e.g. U1) to supply the
entirety of the WIFI PCB

3 PRE-TERM 4 PG 5 NC 6

Check power supply
sequencing for SI chip: can
the 1.8 turn on at the same
time as 3.3? not a problem
with the graphs.
the problem is if we want to
control the LD_EN with the
mcu. at start the siwg can't
work properly so can't use it.
the VBATT of the mcu must
be high with the other supply
or the first one, but can be
later

Instead of fuel gauge
just add resistor divider
to ADC pin of MCU
3V3_VBUSR35

This board: 3.3V: 21.2uF 1.8V: 23.6uF Make sure that only either R28 or R30

Power tree and configurations:

Power scenario: resistors to place ------------------------------
