ssavazzi02/tinyProbe_wius/wius_new.kicad_pcb

## KiCad design wius_new.kicad_pcb (2026-09-01)

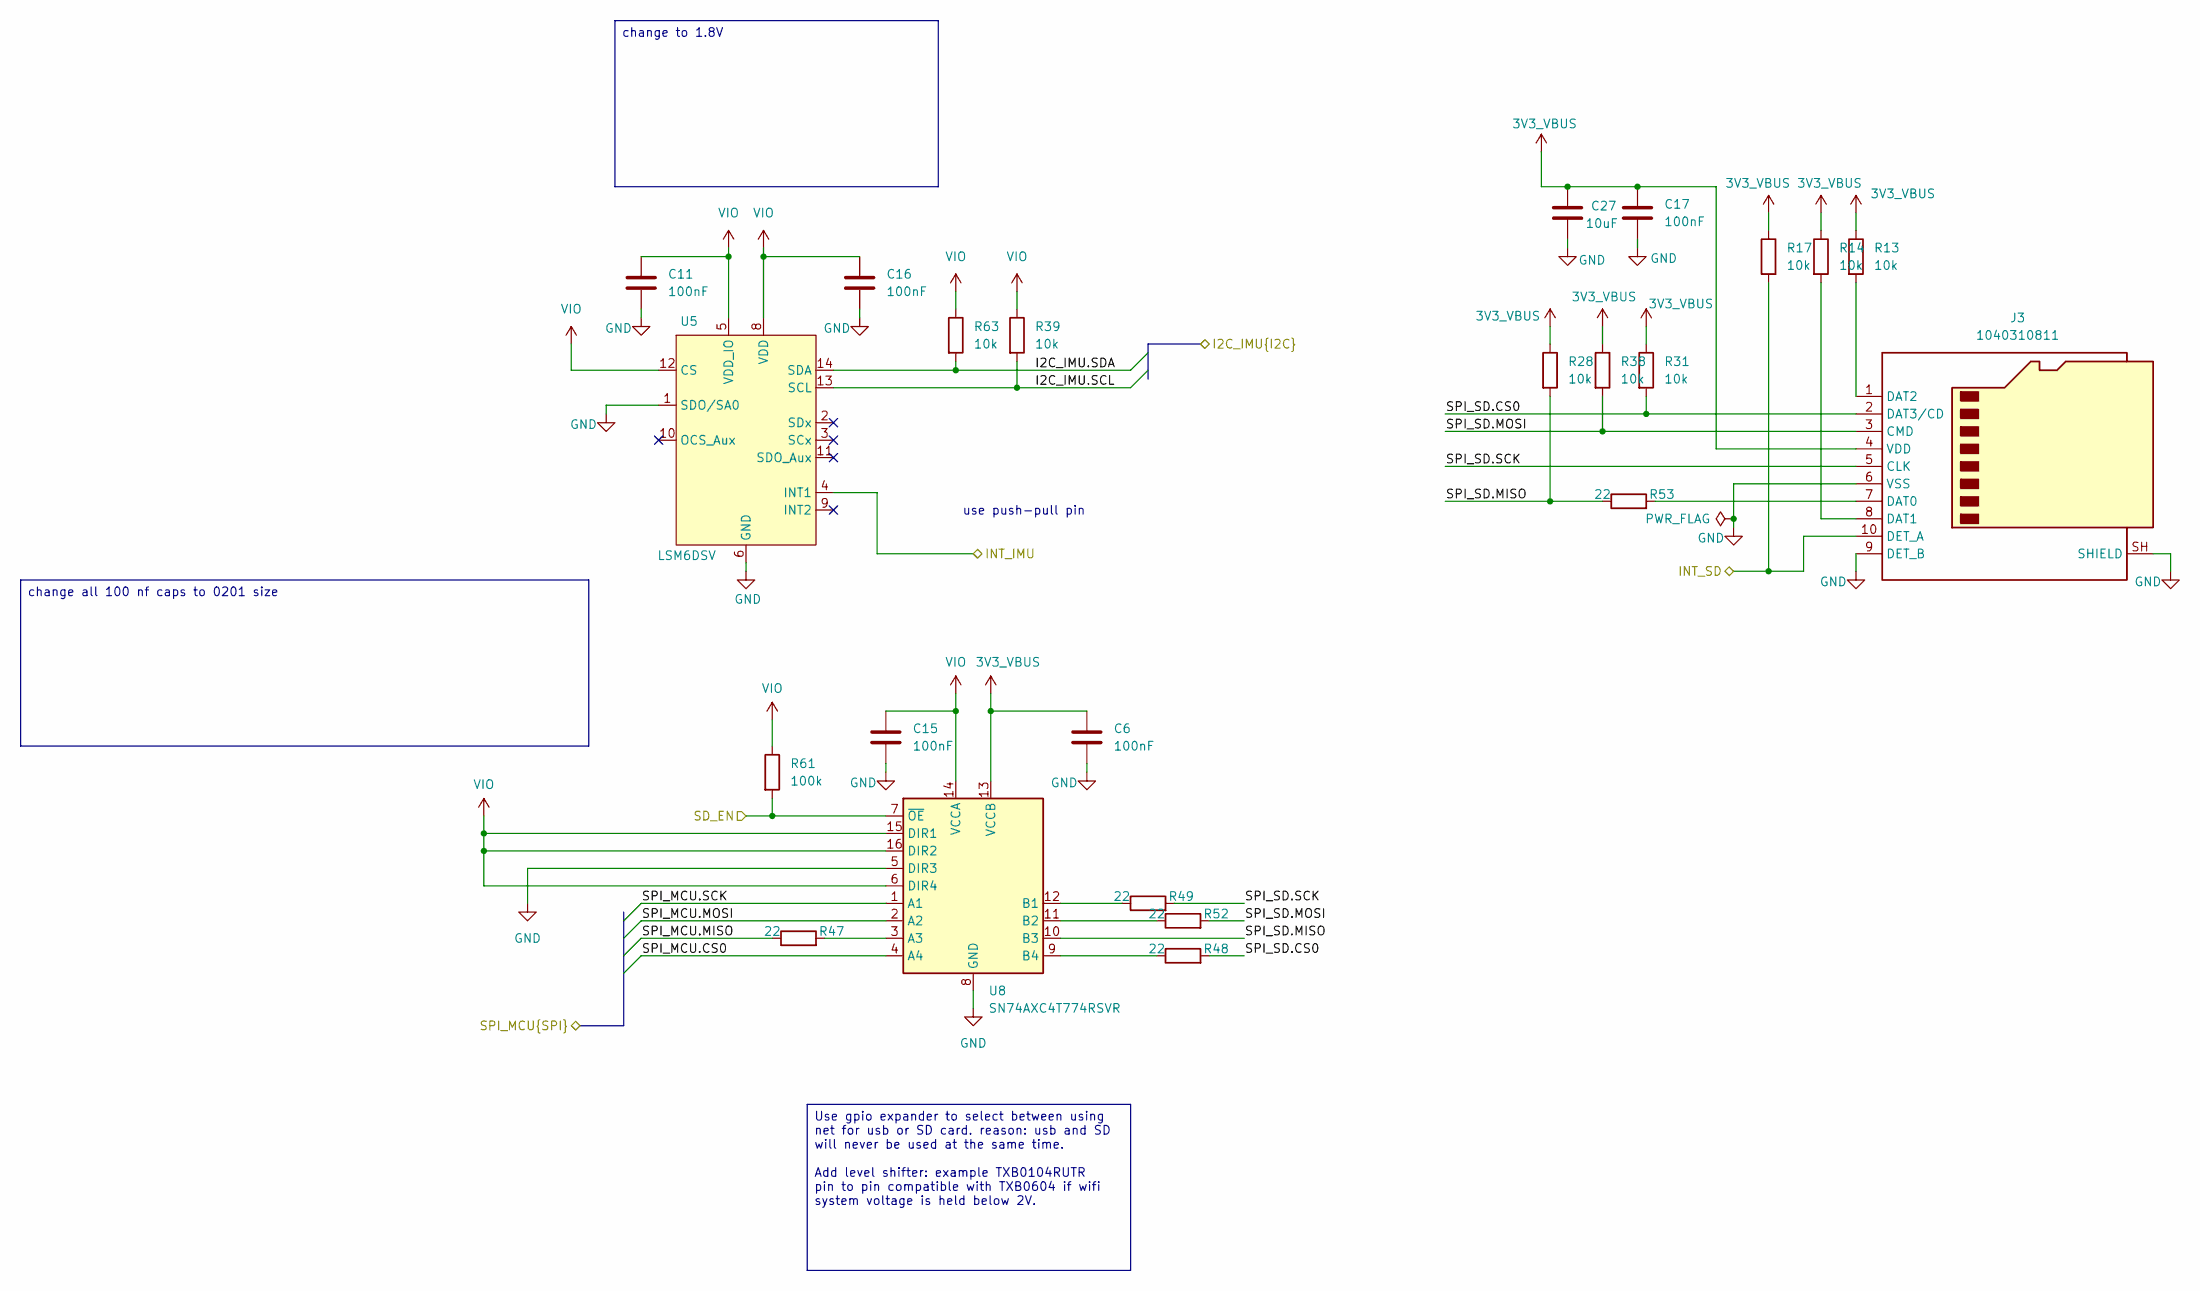
[picture p26: schematic Peripherals.kicad_sch]

Parts:
C6, C11, C15, C16, C17: 100nF; C_0201_0603Metric; Voltage 10V; Tolerance 20%; MPN GRM033R61A104ME15
C27: 10uF; C_0603_1608Metric; Voltage 10V; Tolerance 20%; MPN GRM188R61A106ME69; LCSC C197020603
J3: 1040310811; microSD_HC_Molex_104031-0811; MPN 1040310811; LCSC C585350
R13, R14, R17, R28, R31, R38, R39, R63: 10k; R_0201_0603Metric; Tolerance 1%; MPN ERJ-1GJF1002C; LCSC C20021044
R47, R48, R49, R52, R53: 22; R_0201_0603Metric; Tolerance 1%; MPN ERJ-1GJF22R0C; LCSC C20021234
R61: 100k; R_0201_0603Metric; Tolerance 1%; MPN ERJ-1GJF1003C; LCSC C20021045
U5: LSM6DSV; LGA-14_3x2.5mm_P0.5mm_LayoutBorder3x4y; MPN LSM6DSV; LCSC C5267399
U8: SN74AXC4T774RSVR; UQFN-16_1.8x2.6mm_P0.4mm; MPN SN74AXC4T774RSVR; LCSC C1849454

Connections:
3V3_VBUS: C6.1, C17.1, C27.1, J3.4 (VDD), R13.1, R14.1, R17.1, R28.1, R31.1, R38.1, U8.13 (VCCB); also elsewhere on the board
/IMU_SD/I2C_IMU.SCL: R39.2, U5.13 (SCL); also elsewhere on the board
/IMU_SD/I2C_IMU.SDA: R63.2, U5.14 (SDA); also elsewhere on the board
/IMU_SD/INT_IMU: U5.4 (INT1); also elsewhere on the board
/IMU_SD/INT_SD: J3.10 (DET_A), R17.2; also elsewhere on the board
/IMU_SD/SD_EN: R61.2, U8.7 (~OE); also elsewhere on the board
/IMU_SD/SPI_MCU.CS0: U8.4 (A4); also elsewhere on the board
/IMU_SD/SPI_MCU.MISO: R47.1; also elsewhere on the board
/IMU_SD/SPI_MCU.MOSI: U8.2 (A2); also elsewhere on the board
/IMU_SD/SPI_MCU.SCK: U8.1 (A1); also elsewhere on the board
/IMU_SD/SPI_SD.CS0: J3.2 (DAT3/CD), R31.2, R48.2
/IMU_SD/SPI_SD.MISO: R28.2, R53.1, U8.10 (B3)
/IMU_SD/SPI_SD.MOSI: J3.3 (CMD), R38.2, R52.2
/IMU_SD/SPI_SD.SCK: J3.5 (CLK), R49.2
GND: C6.2, C11.2, C15.2, C16.2, C17.2, C27.2, J3.6 (VSS), J3.9 (DET_B), J3.SH (SHIELD), U5.1 (SDO/SA0), U5.6 (GND), U5.7 (GND), U8.5 (DIR3), U8.8 (GND); also elsewhere on the board
unnamed: J3.7 (DAT0), R53.2
unnamed: J3.8 (DAT1), R14.2
unnamed: J3.1 (DAT2), R13.2
unnamed: R47.2, U8.3 (A3)
unnamed: R49.1, U8.12 (B1)
unnamed: R52.1, U8.11 (B2)
unnamed: R48.1, U8.9 (B4)
VIO: C11.1, C15.1, C16.1, R39.1, R61.1, R63.1, U5.5 (VDD_IO), U5.8 (VDD), U5.12 (CS), U8.6 (DIR4), U8.14 (VCCA), U8.15 (DIR1), U8.16 (DIR2); also elsewhere on the board

Notes on the sheet:
use push-pull pin
change to 1.8V
Use gpio expander to select between using net for usb or SD card. reason: usb and SD will never be used at the same time. Add level shifter: example TXB0104RUTR pin to pin compatible with TXB0604 if wifi system voltage is held below 2V.
change all 100 nf caps to 0201 size

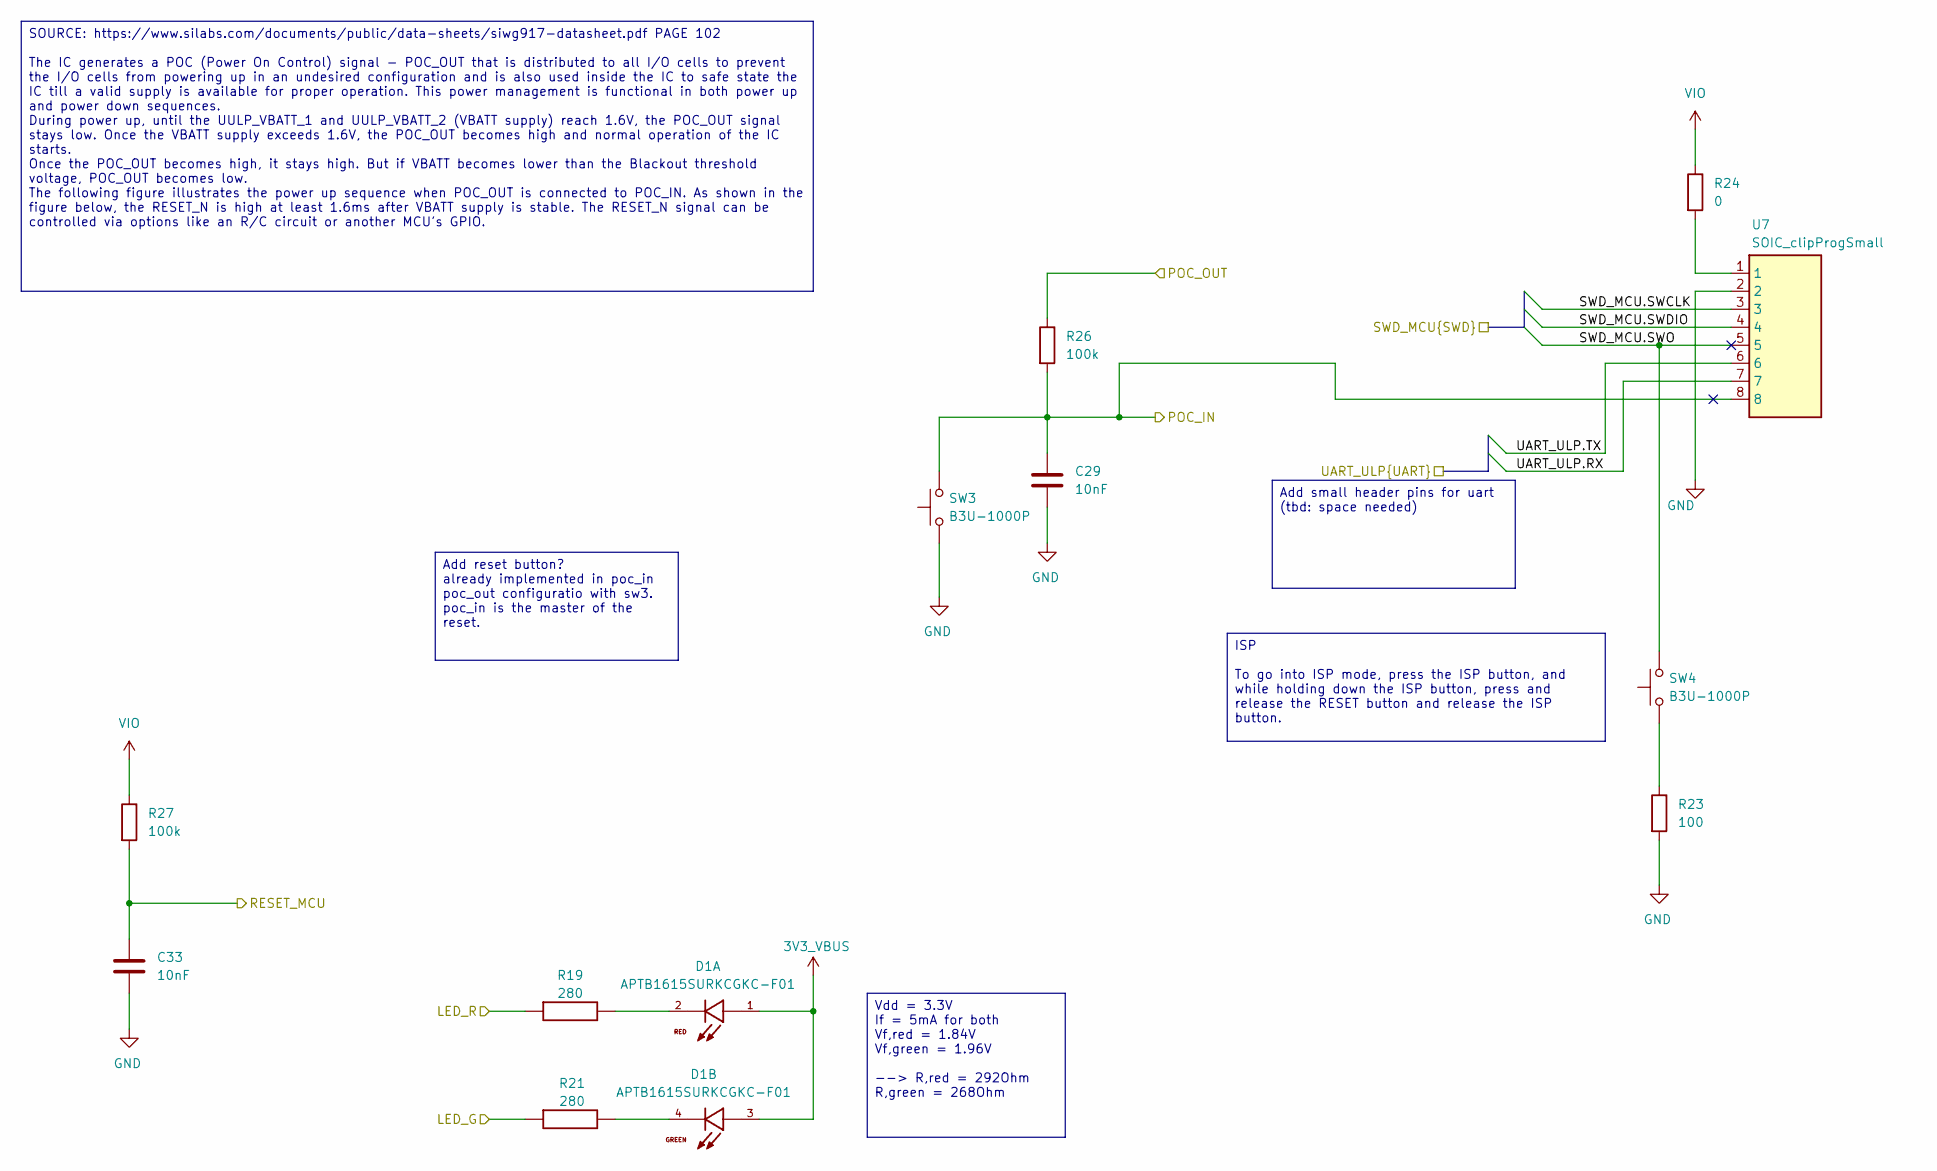
[picture p27: schematic debug_interface.kicad_sch]

Parts:
C29, C33: 10nF; C_0402_1005Metric; Tolerance 10%; Voltage 50V; MPN GRM155R71H103KA88J; LCSC C91601
D1: APTB1615SURKCGKC-F01; LED_APTB1615SURKCGKC-F01; MPN APTB1615SURKCGKC-F01; LCSC C5879208
R19, R21: 280; RESC1005X40N; Tolerance 1%; MPN RC0402FR-07280RL; LCSC C273692
R23: 100; R_0402_1005Metric; Tolerance 1%; MPN ERJ-2RKF1000X; LCSC C413063
R24: 0; R_0402_1005Metric; Tolerance 5%; MPN ERJ-2GE0R00X; LCSC C17168
R26, R27: 100k; R_0402_1005Metric; Tolerance 1%; MPN ERJ-2RKF1003X; LCSC C192169
SW3, SW4: Button Switch SPST-No; SW_SPST_B3U-1000P; MPN B3U-1000P; LCSC C231329
U7: SOIC_clipProgSmall

Connections:
3V3_VBUS: D1.1, D1.3; also elsewhere on the board
/DEBUG, RESET & POC_IN, PROGRAMMING INTERFACE/LED_G: R21.1; also elsewhere on the board
/DEBUG, RESET & POC_IN, PROGRAMMING INTERFACE/LED_R: R19.1; also elsewhere on the board
/DEBUG, RESET & POC_IN, PROGRAMMING INTERFACE/SWD_MCU.SWCLK: U7.3; also elsewhere on the board
/DEBUG, RESET & POC_IN, PROGRAMMING INTERFACE/SWD_MCU.SWDIO: U7.4; also elsewhere on the board
/DEBUG, RESET & POC_IN, PROGRAMMING INTERFACE/SWD_MCU.SWO: SW4.2, U7.5; also elsewhere on the board
/DEBUG, RESET & POC_IN, PROGRAMMING INTERFACE/UART_ULP.RX: U7.7; also elsewhere on the board
/DEBUG, RESET & POC_IN, PROGRAMMING INTERFACE/UART_ULP.TX: U7.6; also elsewhere on the board
/MCU/MCU_POWER_RF/POC_IN: C29.1, R26.2, SW3.2, U7.8; also elsewhere on the board
/MCU/MCU_POWER_RF/POC_OUT: R26.1; also elsewhere on the board
/MCU/MCU_POWER_RF/RESET_MCU: C33.1, R27.2; also elsewhere on the board
GND: C29.2, C33.2, R23.2, SW3.1, U7.2; also elsewhere on the board
unnamed: D1.2, R19.2
unnamed: D1.4, R21.2
unnamed: R23.1, SW4.1
unnamed: R24.2, U7.1
VIO: R24.1, R27.1; also elsewhere on the board

Notes on the sheet:
Vdd = 3.3V If = 5mA for both Vf,red = 1.84V Vf,green = 1.96V --> R,red = 292Ohm R,green = 268Ohm
Add reset button? already implemented in poc_in poc_out configuratio with sw3. poc_in is the master of the reset.
Add small header pins for uart (tbd: space needed)
SOURCE: https://www.silabs.com/documents/public/data-sheets/siwg917-datasheet.pdf PAGE 102 The IC generates a POC (Power On Control) signal - POC_OUT that is distributed to all I/O cells to prevent the I/O cells from powering up in an undesired configuration and is also used inside the IC to safe s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
ISP To go into ISP mode, press the ISP button, and while holding down the ISP button, press and release the RESET button and release the ISP button.

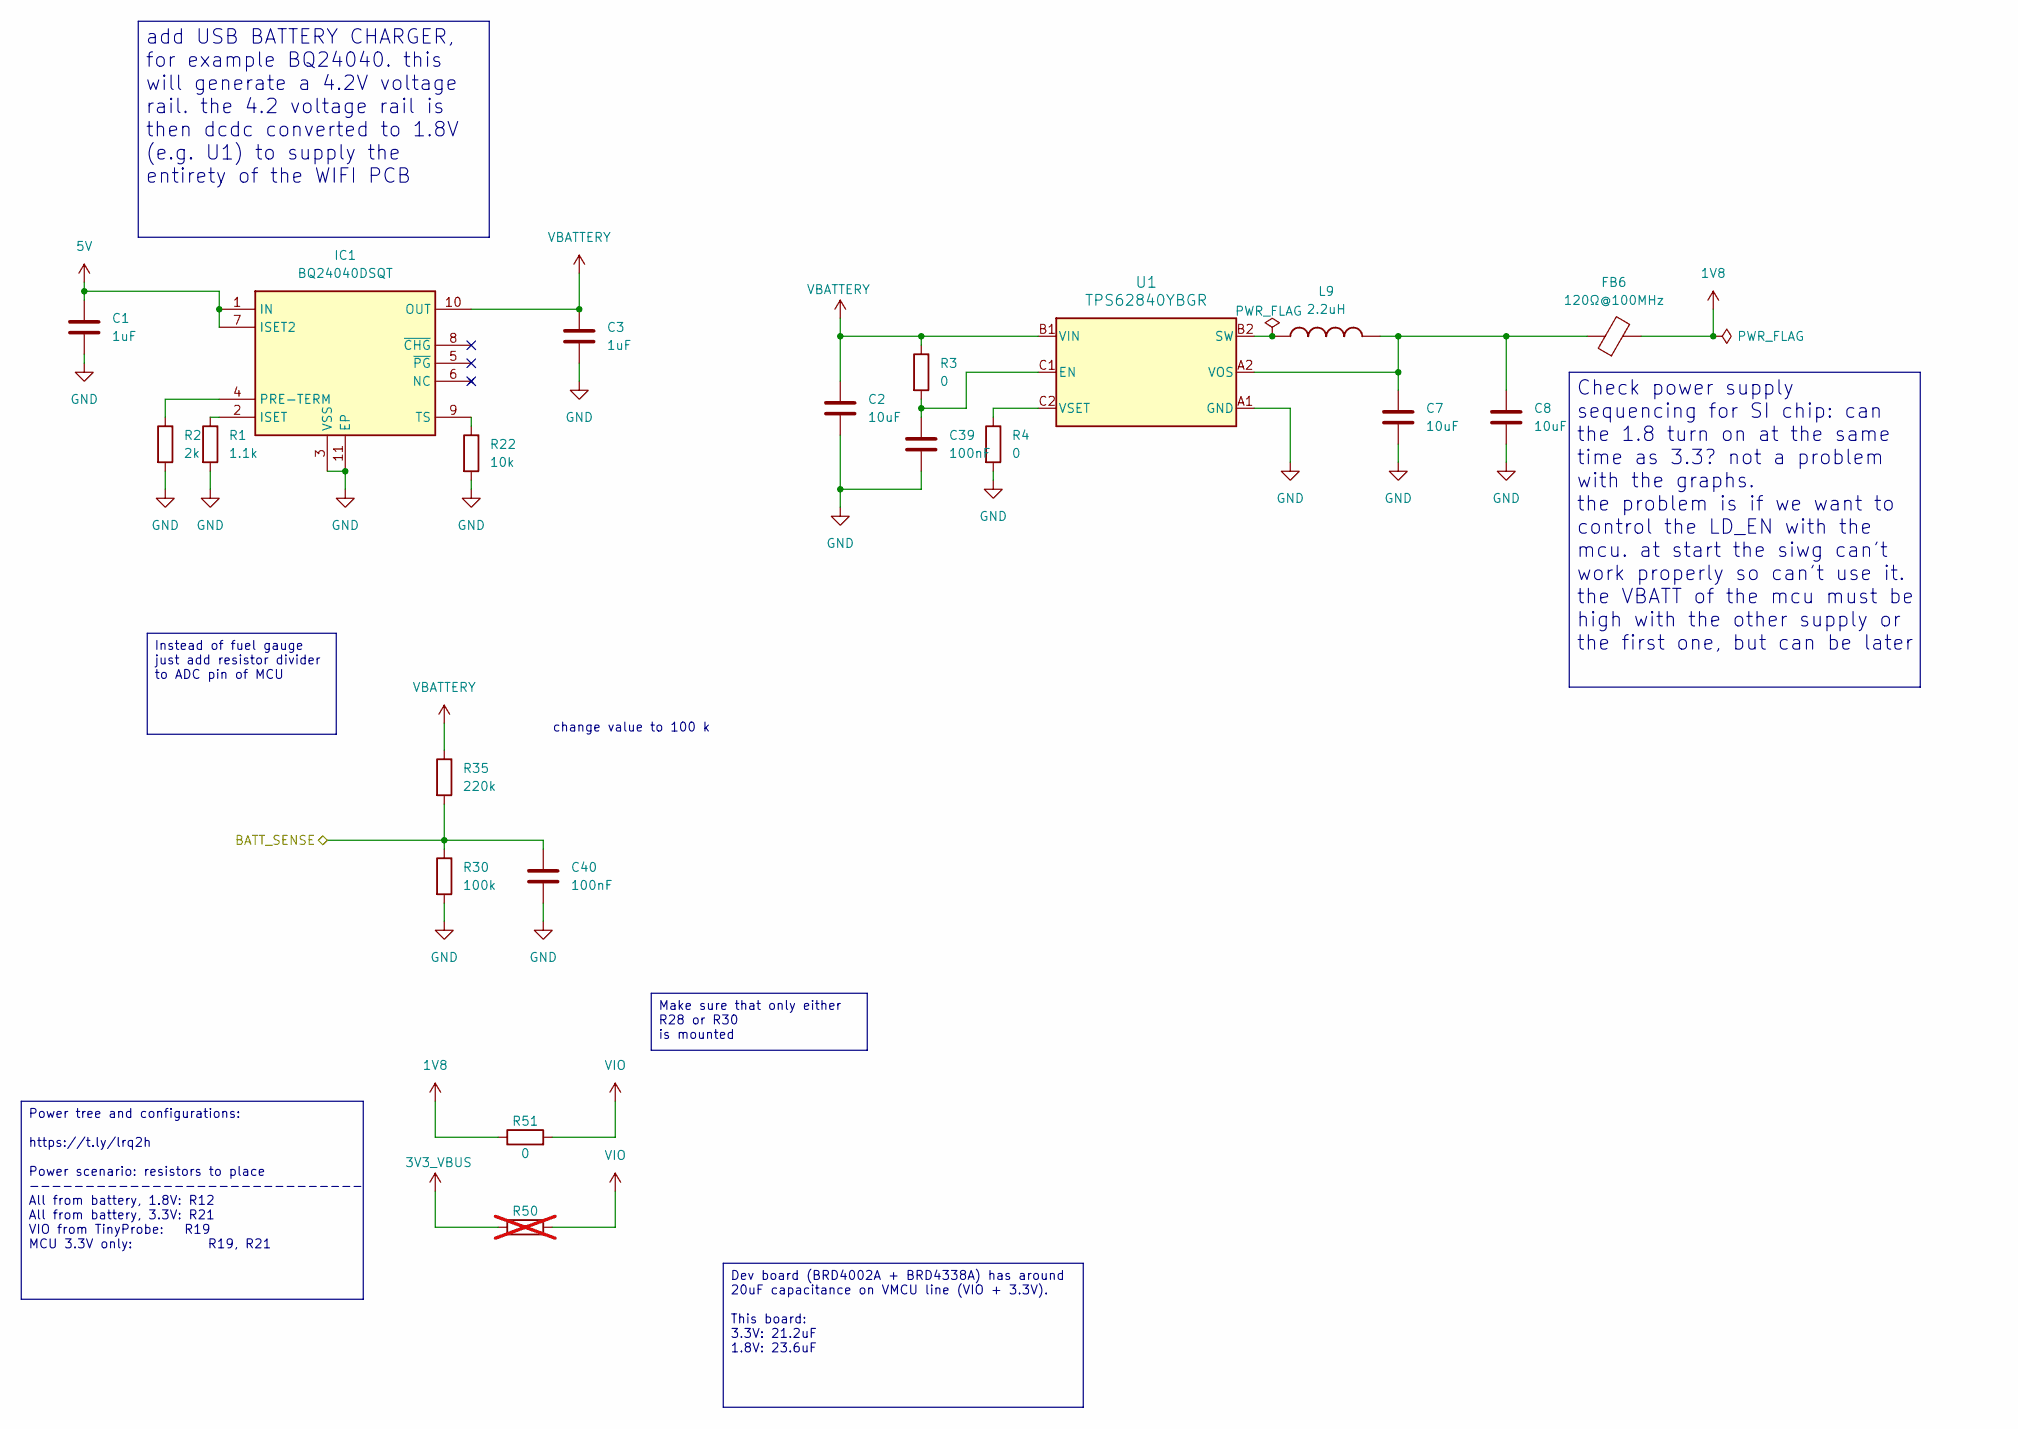
[picture p28: schematic power_conv.kicad_sch]

Parts:
C1, C3: 1uF; C_0402_1005Metric; Voltage 16V; Tolerance 20%; MPN GRM155R61C105MA12; LCSC C77009
C2, C7, C8: 10uF; C_0603_1608Metric; Voltage 10V; Tolerance 20%; MPN GRM188R61A106ME69; LCSC C197020603
C39, C40: 100nF; C_0201_0603Metric; Voltage 10V; Tolerance 20%; MPN GRM033R61A104ME15
FB6: 120Ω@100MHz; BLM15KD121SN1D; MPN BLM15KD121SN1D; LCSC C710343
IC1: BQ24040DSQT; MPN BQ24040DSQT; LCSC C2876332
L9: 2.2uH; DFE2MCAH2R2MJ0L; MPN DFE2MCAH2R2MJ0L; LCSC C2045354
R1: 1.1k; R_0402_1005Metric; Tolerance 0.1%; MPN RT0402BRE071K1L; LCSC C853096
R2: 2k; R_0402_1005Metric; Tolerance 0.5%; MPN RT0402DRD072KL; LCSC C853619
R3, R4, R51: 0; R_0402_1005Metric; Tolerance 5%; MPN ERJ-2GE0R00X; LCSC C17168
R22: 10k; R_0402_1005Metric; Tolerance 1%; MPN ERJ-2RKF1002X; LCSC C191123
R30: 100k; R_0402_1005Metric; Tolerance 1%; MPN ERJ-2RKF1003X; LCSC C192169
R35: 220k; R_0402_1005Metric; Tolerance 1%; MPN ERJ-2RKF2203X; LCSC C413112
R50: 0; R_0402_1005Metric; Tolerance 5%; MPN ERJ-2GE0R00X; LCSC C17168; not fitted
U1: TPS62840YBGR; Texas_DSBGA-6_0.9x1.4mm_Layout2x3_P0.5mm; MPN TPS62840YBGR; LCSC 1.5MHz-2.5MHz

Connections:
1V8: FB6.2, R51.1
3V3_VBUS: R50.1; also elsewhere on the board
5V: C1.1, IC1.1 (IN), IC1.7 (ISET2); also elsewhere on the board
/MCU/BATT_SENSE: C40.1, R30.1, R35.2; also elsewhere on the board
GND: C1.2, C2.2, C3.2, C7.2, C8.2, C39.2, C40.2, IC1.3 (VSS), IC1.11 (EP), R1.2, R2.2, R4.2, R22.2, R30.2, U1.A1 (GND); also elsewhere on the board
unnamed: IC1.2 (ISET), R1.1
unnamed: IC1.4 (PRE-TERM), R2.1
unnamed: IC1.9 (TS), R22.1
unnamed: C39.1, R3.2, U1.C1 (EN)
unnamed: L9.1, U1.B2 (SW)
unnamed: C7.1, C8.1, FB6.1, L9.2, U1.A2 (VOS)
unnamed: R4.1, U1.C2 (VSET)
VBATTERY: C2.1, C3.1, IC1.10 (OUT), R3.1, R35.1, U1.B1 (VIN); also elsewhere on the board
VIO: R50.2, R51.2; also elsewhere on the board

Notes on the sheet:
change value to 100 k
add USB BATTERY CHARGER, for example BQ24040. this will generate a 4.2V voltage rail. the 4.2 voltage rail is then dcdc converted to 1.8V (e.g. U1) to supply the entirety of the WIFI PCB
Power tree and configurations: https://t.ly/lrq2h Power scenario: resistors to place ------------------------------ All from battery, 1.8V: R12 All from battery, 3.3V: R21 VIO from TinyProbe: R19 MCU 3.3V only: R19, R21
Dev board (BRD4002A + BRD4338A) has around 20uF capacitance on VMCU line (VIO + 3.3V). This board: 3.3V: 21.2uF 1.8V: 23.6uF
Make sure that only either R28 or R30 is mounted
Check power supply sequencing for SI chip: can the 1.8 turn on at the same time as 3.3? not a problem with the graphs. the problem is if we want to control the LD_EN with the mcu. at start the siwg can't work properly so can't use it. the VBATT of the mcu must be high with the other supply or the f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
Instead of fuel gauge just add resistor divider to ADC pin of MCU

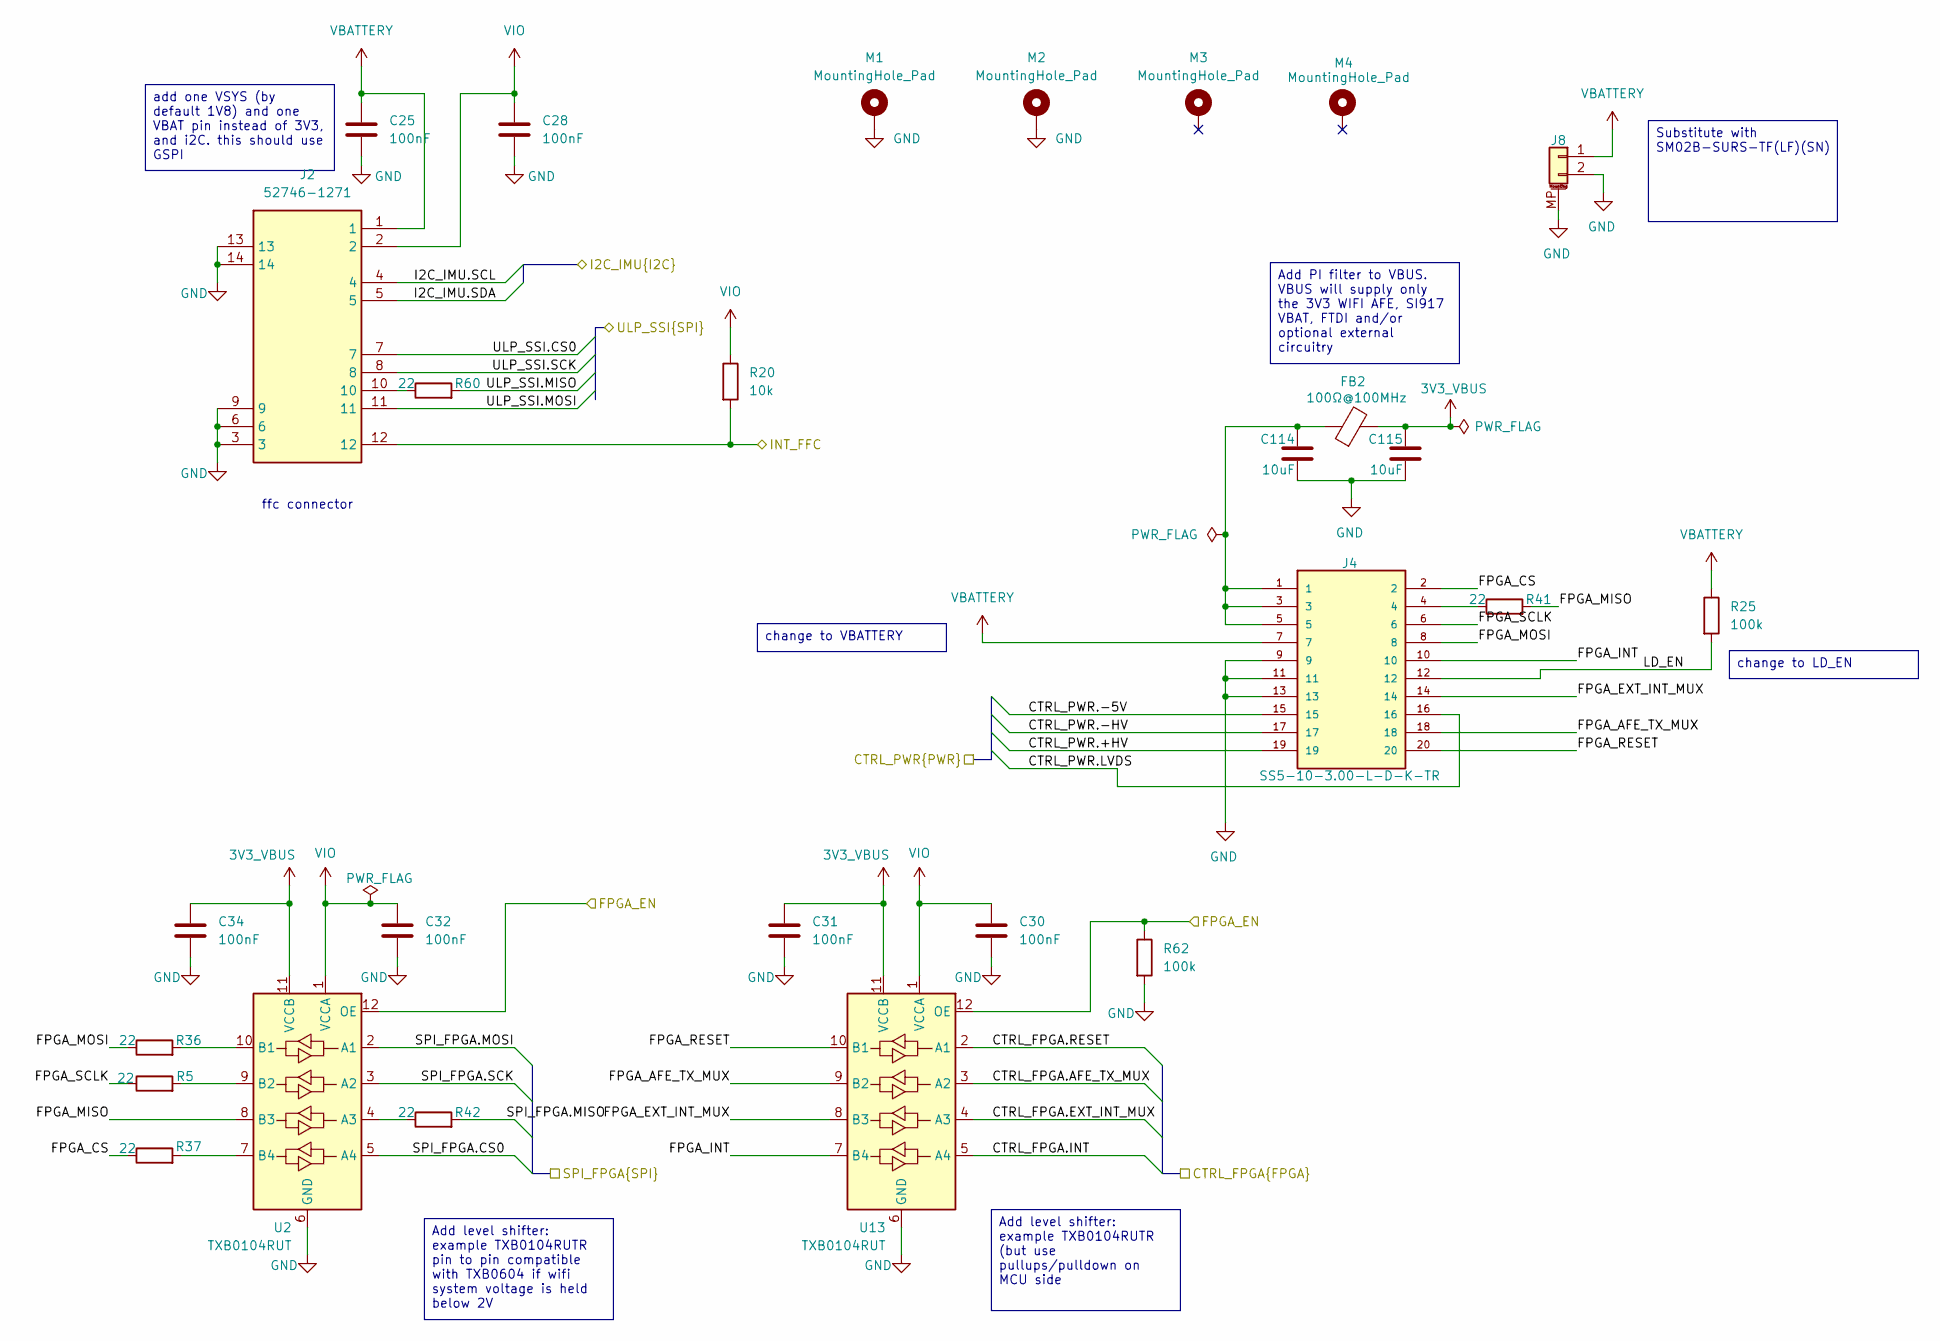
[picture p29: schematic connectors.kicad_sch]

Parts:
C25, C28, C30, C31, C32, C34: 100nF; C_0201_0603Metric; Voltage 10V; Tolerance 20%; MPN GRM033R61A104ME15
C114, C115: 10uF; C_0402_1005Metric; Voltage 10V; Tolerance 20%; MPN GRM155R61A106ME11; LCSC C408132
FB2: 100Ω@100MHz; L_0603_1608Metric; MPN BLM18SP101SN1; LCSC C3717002
J2: 52746-1271; 527461271; MPN 52746-1271; LCSC C588231
J4: SS5-10-3.00-L-D-K-TR; SAMTEC_SS5_10_3.00_X_D_K_XX; MPN SS5-10-3.00-L-D-K-TR; LCSC C7087204
J8: 2; JST_SUR_SM02B-SURS-TF_1x02-1MP_P0.80mm_Horizontal; MPN SM02B-SURS-TF(LF)(SN)
M1, M2, M3, M4: MountingHole_Pad; MountingHole_2.4mm_M2_Pad_TopBottom
R5, R36, R37, R41, R42, R60: 22; R_0201_0603Metric; Tolerance 1%; MPN ERJ-1GJF22R0C; LCSC C20021234
R20: 10k; R_0201_0603Metric; Tolerance 1%; MPN ERJ-1GJF1002C; LCSC C20021044
R25: 100k; R_0402_1005Metric; Tolerance 1%; MPN ERJ-2RKF1003X; LCSC C192169
R62: 100k; R_0201_0603Metric; Tolerance 1%; MPN ERJ-1GJF1003C; LCSC C20021045
U2, U13: TXB0104RUT; Texas_R-PUQFN-N12

Connections:
3V3_VBUS: C31.1, C34.1, C115.1, FB2.2, U2.11 (VCCB), U13.11 (VCCB); also elsewhere on the board
/IMU_SD/I2C_IMU.SCL: J2.4; also elsewhere on the board
/IMU_SD/I2C_IMU.SDA: J2.5; also elsewhere on the board
/MCU/CTRL_FPGA.AFE_TX_MUX: U13.3 (A2); also elsewhere on the board
/MCU/CTRL_FPGA.EXT_INT_MUX: U13.4 (A3); also elsewhere on the board
/MCU/CTRL_FPGA.INT: U13.5 (A4); also elsewhere on the board
/MCU/CTRL_FPGA.RESET: U13.2 (A1); also elsewhere on the board
/MCU/CTRL_PWR.+HV: J4.19; also elsewhere on the board
/MCU/CTRL_PWR.-5V: J4.15; also elsewhere on the board
/MCU/CTRL_PWR.-HV: J4.17; also elsewhere on the board
/MCU/CTRL_PWR.LVDS: J4.16; also elsewhere on the board
/MCU/FPGA_EN: R62.1, U2.12 (OE), U13.12 (OE); also elsewhere on the board
/MCU/INT_FFC: J2.12, R20.2; also elsewhere on the board
/MCU/SPI_FPGA.CS0: U2.5 (A4); also elsewhere on the board
/MCU/SPI_FPGA.MISO: R42.2; also elsewhere on the board
/MCU/SPI_FPGA.MOSI: U2.2 (A1); also elsewhere on the board
/MCU/SPI_FPGA.SCK: U2.3 (A2); also elsewhere on the board
/MCU/ULP_SSI.CS0: J2.7; also elsewhere on the board
/MCU/ULP_SSI.MISO: R60.2; also elsewhere on the board
/MCU/ULP_SSI.MOSI: J2.11; also elsewhere on the board
/MCU/ULP_SSI.SCK: J2.8; also elsewhere on the board
/connectors/FPGA_AFE_TX_MUX: J4.18, U13.9 (B2)
/connectors/FPGA_CS: J4.2, R37.1
/connectors/FPGA_EXT_INT_MUX: J4.14, U13.8 (B3)
/connectors/FPGA_INT: J4.10, U13.7 (B4)
/connectors/FPGA_MISO: R41.2, U2.8 (B3)
/connectors/FPGA_MOSI: J4.8, R36.1
/connectors/FPGA_RESET: J4.20, U13.10 (B1)
/connectors/FPGA_SCLK: J4.6, R5.1
/connectors/LD_EN: J4.12, R25.2
GND: C25.2, C28.2, C30.2, C31.2, C32.2, C34.2, C114.2, C115.2, J2.3, J2.6, J2.9, J2.13, J2.14, J4.9, J4.11, J4.13, J8.2, J8.MP (MountPin), M1.1 (1_1), M2.1 (1_1), R62.2, U2.6 (GND), U13.6 (GND); also elsewhere on the board
unnamed: C114.1, FB2.1, J4.1, J4.3, J4.5
unnamed: J2.10, R60.1
unnamed: J4.4, R41.1
unnamed: R42.1, U2.4 (A3)
unnamed: R36.2, U2.10 (B1)
unnamed: R5.2, U2.9 (B2)
unnamed: R37.2, U2.7 (B4)
VBATTERY: C25.1, J2.1, J4.7, J8.1, R25.1; also elsewhere on the board
VIO: C28.1, C30.1, C32.1, J2.2, R20.1, U2.1 (VCCA), U13.1 (VCCA); also elsewhere on the board

Notes on the sheet:
ffc connector
Add level shifter: example TXB0104RUTR pin to pin compatible with TXB0604 if wifi system voltage is held below 2V
change to LD_EN
Add PI filter to VBUS. VBUS will supply only the 3V3 WIFI AFE, SI917 VBAT, FTDI and/or optional external circuitry
Substitute with SM02B-SURS-TF(LF)(SN)
add one VSYS (by default 1V8) and one VBAT pin instead of 3V3, and i2C. this should use GSPI
Add level shifter: example TXB0104RUTR (but use pullups/pulldown on MCU side
change to VBATTERY

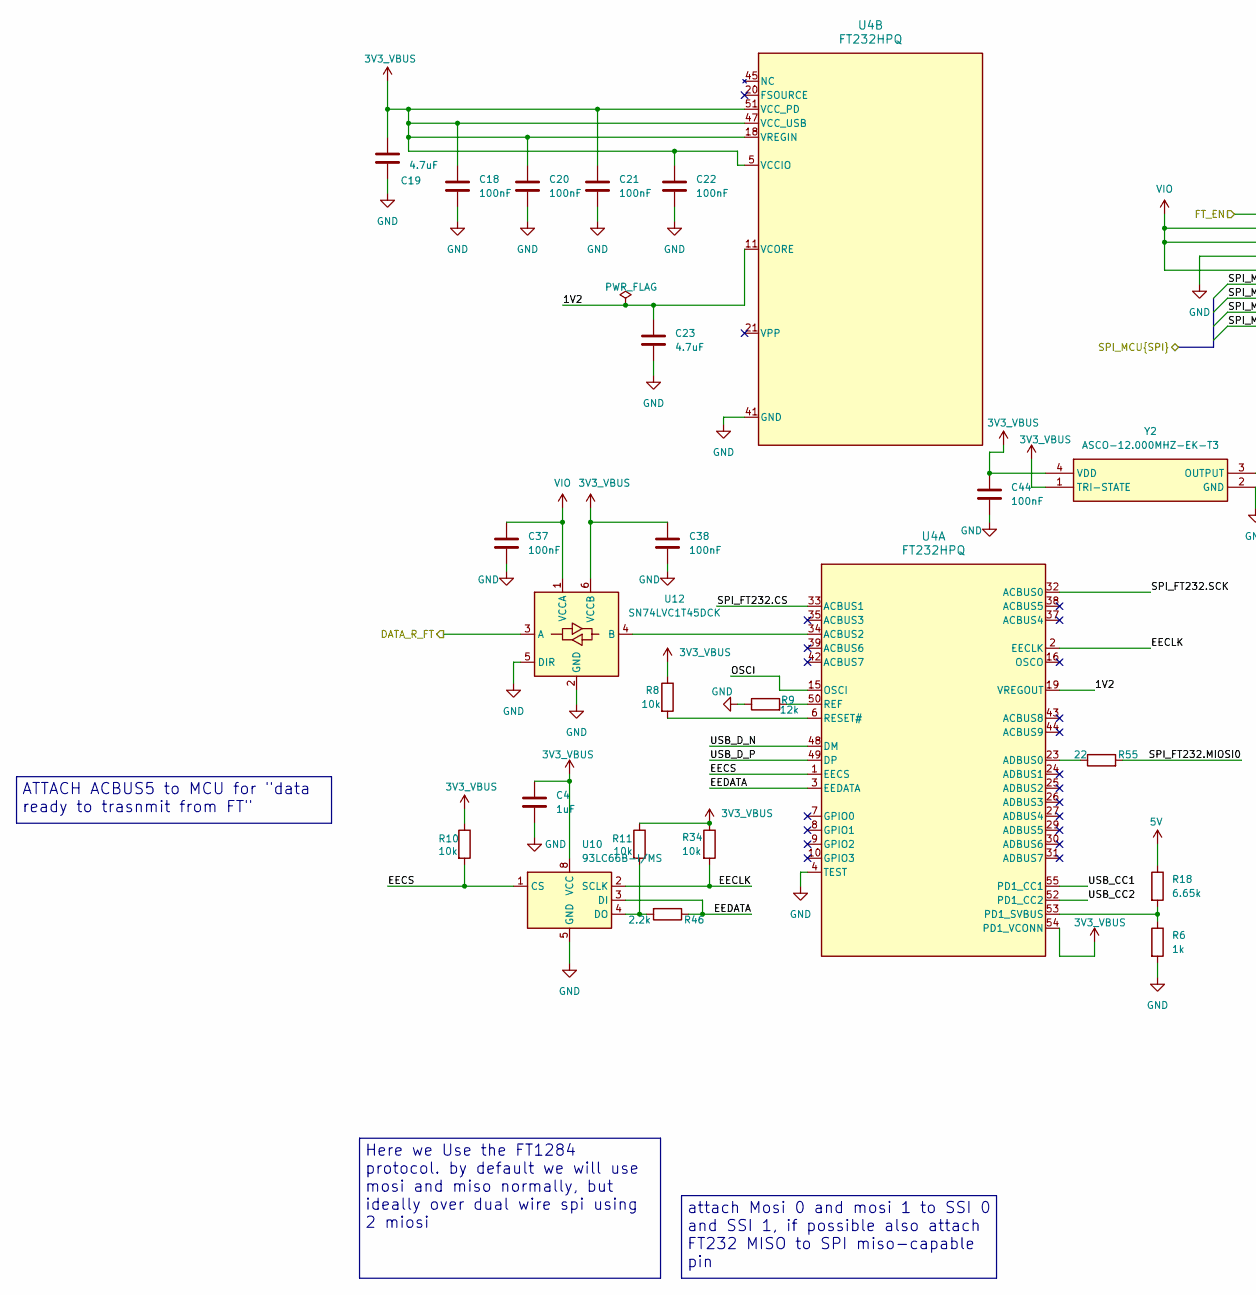
[picture p30: schematic Power_&_USB.kicad_sch, part in row 1, column 1]

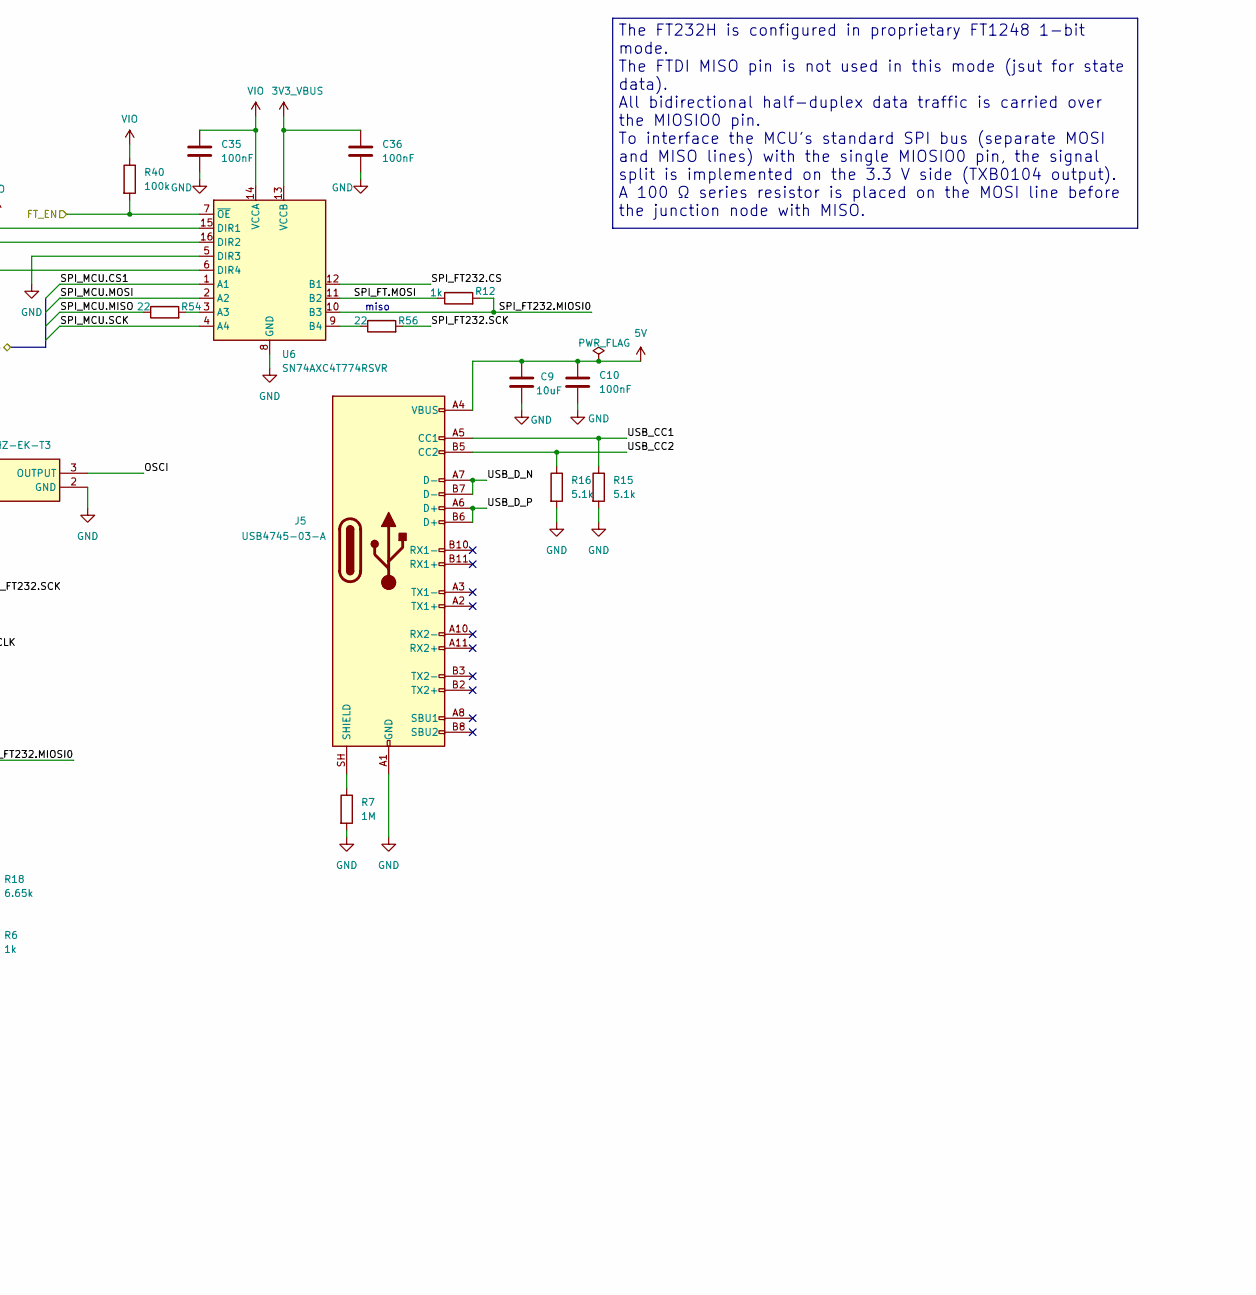
[picture p31: schematic Power_&_USB.kicad_sch, part in row 1, column 2]

Parts:
C4: 1uF; C_0201_0603Metric; Voltage 10V; Tolerance 20%; MPN GRM033R61A105ME15; LCSC C274414
C9: 10uF; C_0603_1608Metric; Voltage 10V; Tolerance 20%; MPN GRM188R61A106ME69; LCSC C197020603
C10, C18, C20, C21, C22, C35, C36, C37, C38, C44: 100nF; C_0201_0603Metric; Voltage 10V; Tolerance 20%; MPN GRM033R61A104ME15
C19, C23: 4.7uF; C_0402_1005Metric; Tolerance 20%; Voltage 25V; MPN GRM155C61E475ME15; LCSC C2858031
J5: USB4745-03-A; GTC_USB4745; MPN USB4745-03-A; LCSC C2911517
R6, R12: 1k; R_0402_1005Metric; Tolerance 1%; MPN ERJ-2RKF1001X; LCSC C242161
R7: 1M; R_0402_1005Metric; Tolerance 1%; MPN ERJ-2RKF1004X; LCSC C413126
R8, R10, R11, R34: 10k; R_0201_0603Metric; Tolerance 1%; MPN ERJ-1GJF1002C; LCSC C20021044
R9: 12k; R_0201_0603Metric; Tolerance 1%; MPN ERJ-1GJF1202C; LCSC C20021084
R15, R16: 5.1k; R_0402_1005Metric; Tolerance 1%; MPN ERJ-2RKF5101X; LCSC C278598
R18: 6.65k; R_0402_1005Metric; Tolerance 1%; MPN RC0402FR-076K65L; LCSC C185400
R40: 100k; R_0201_0603Metric; Tolerance 1%; MPN ERJ-1GJF1003C; LCSC C20021045
R46: 2.2k; R_0201_0603Metric; Tolerance 1%; MPN ERJ-1GJF2201C; LCSC C20021223
R54, R55, R56: 22; R_0201_0603Metric; Tolerance 1%; MPN ERJ-1GJF22R0C; LCSC C20021234
U4: FT232HPQ; QFN-56_FT232HPQ_FTD; MPN FT232HPQ; LCSC C3227934
U6: SN74AXC4T774RSVR; UQFN-16_1.8x2.6mm_P0.4mm; MPN SN74AXC4T774RSVR; LCSC C1849454
U10: 93LC66B-I/MS; MSOP8_MC_MCH; MPN 93LC66B-I/MS
U12: SN74LVC1T45DCK; SOT-363_SC-70-6
Y2: ASCO-12.000MHZ-EK-T3; Oscillator_SMD_Abracon_ASCO-4Pin_1.6x1.2mm; MPN ASCO-12.000MHZ-EK-T3; Mouser Part Number 815-ASCO-12-EK-T3

Connections:
3V3_VBUS: C4.1, C18.1, C19.1, C20.1, C21.1, C22.1, C36.1, C38.1, C44.1, R8.1, R10.1, R11.1, R34.1, U4.5 (VCCIO), U4.13 (VCCIO), U4.14 (VCCIO), U4.18 (VREGIN), U4.28 (VCCIO), U4.40 (VCCIO), U4.47 (VCC_USB), U4.51 (VCC_PD), U4.54 (PD1_VCONN), U6.13 (VCCB), U10.8 (VCC), U12.6 (VCCB), Y2.1 (TRI-STATE), Y2.4 (VDD); also elsewhere on the board
5V: C9.1, C10.1, J5.A4 (VBUS), J5.A9 (VBUS), J5.B4 (VBUS), J5.B9 (VBUS), R18.1; also elsewhere on the board
/IMU_SD/SPI_MCU.CS1: U6.1 (A1); also elsewhere on the board
/IMU_SD/SPI_MCU.MISO: R54.1; also elsewhere on the board
/IMU_SD/SPI_MCU.MOSI: U6.2 (A2); also elsewhere on the board
/IMU_SD/SPI_MCU.SCK: U6.4 (A4); also elsewhere on the board
/MCU/DATA_R_FT: U12.3 (A); also elsewhere on the board
/MCU/FT_EN: R40.2, U6.7 (~OE); also elsewhere on the board
/USB_FT232HPQ/1V2: C23.1, U4.11 (VCORE), U4.19 (VREGOUT), U4.22 (VCORE), U4.36 (VCORE), U4.46 (VCORE), U4.56 (VCORE)
/USB_FT232HPQ/EECLK: R34.2, U4.2 (EECLK), U10.2 (SCLK)
/USB_FT232HPQ/EECS: R10.2, U4.1 (EECS), U10.1 (CS)
/USB_FT232HPQ/EEDATA: R46.1, U4.3 (EEDATA), U10.3 (DI)
/USB_FT232HPQ/OSCI: U4.15 (OSCI), Y2.3 (OUTPUT)
/USB_FT232HPQ/SPI_FT232.CS: U4.33 (ACBUS1), U6.12 (B1)
/USB_FT232HPQ/SPI_FT232.MIOSI0: R12.2, R55.2, U6.10 (B3)
/USB_FT232HPQ/SPI_FT232.SCK: R56.2, U4.32 (ACBUS0)
/USB_FT232HPQ/SPI_FT.MOSI: R12.1, U6.11 (B2)
/USB_FT232HPQ/USB_CC1: J5.A5 (CC1), R15.1, U4.55 (PD1_CC1)
/USB_FT232HPQ/USB_CC2: J5.B5 (CC2), R16.1, U4.52 (PD1_CC2)
/USB_FT232HPQ/USB_D_N: J5.A7 (D-), J5.B7 (D-), U4.48 (DM)
/USB_FT232HPQ/USB_D_P: J5.A6 (D+), J5.B6 (D+), U4.49 (DP)
GND: C4.2, C9.2, C10.2, C18.2, C19.2, C20.2, C21.2, C22.2, C23.2, C35.2, C36.2, C37.2, C38.2, C44.2, J5.A1 (GND), J5.A12 (GND), J5.B1 (GND), J5.B12 (GND), R6.2, R7.2, R9.1, R15.2, R16.2, U4.4 (TEST), U4.12 (GND), U4.17 (GND), U4.41 (GND), U4.57 (GND), U6.5 (DIR3), U6.8 (GND), U10.5 (GND), U12.2 (GND), U12.5 (DIR), Y2.2 (GND); also elsewhere on the board
unnamed: J5.SH (SHIELD), R7.1
unnamed: R55.1, U4.23 (ADBUS0)
unnamed: R6.1, R18.2, U4.53 (PD1_SVBUS)
unnamed: R9.2, U4.50 (REF)
unnamed: R8.2, U4.6 (RESET#)
unnamed: R54.2, U6.3 (A3)
unnamed: R56.1, U6.9 (B4)
unnamed: R11.2, R46.2, U10.4 (DO)
unnamed: U4.34 (ACBUS2), U12.4 (B)
VIO: C35.1, C37.1, R40.1, U6.6 (DIR4), U6.14 (VCCA), U6.15 (DIR1), U6.16 (DIR2), U12.1 (VCCA); also elsewhere on the board

Notes on the sheet:
miso
The FT232H is configured in proprietary FT1248 1-bit mode. The FTDI MISO pin is not used in this mode (jsut for state data). All bidirectional half-duplex data traffic is carried over the MIOSIO0 pin. To interface the MCU's standard SPI bus (separate MOSI and MISO lines) with the single MIOSIO0 pin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
ATTACH ACBUS5 to MCU for "data ready to trasnmit from FT"
attach Mosi 0 and mosi 1 to SSI 0 and SSI 1, if possible also attach FT232 MISO to SPI miso-capable pin
Here we Use the FT1284 protocol. by default we will use mosi and miso normally, but ideally over dual wire spi using 2 miosi
