ssavazzi02/tinyProbe_wius/wius_new.kicad_pcb

## KiCad design wius_new.kicad_pcb (continued)

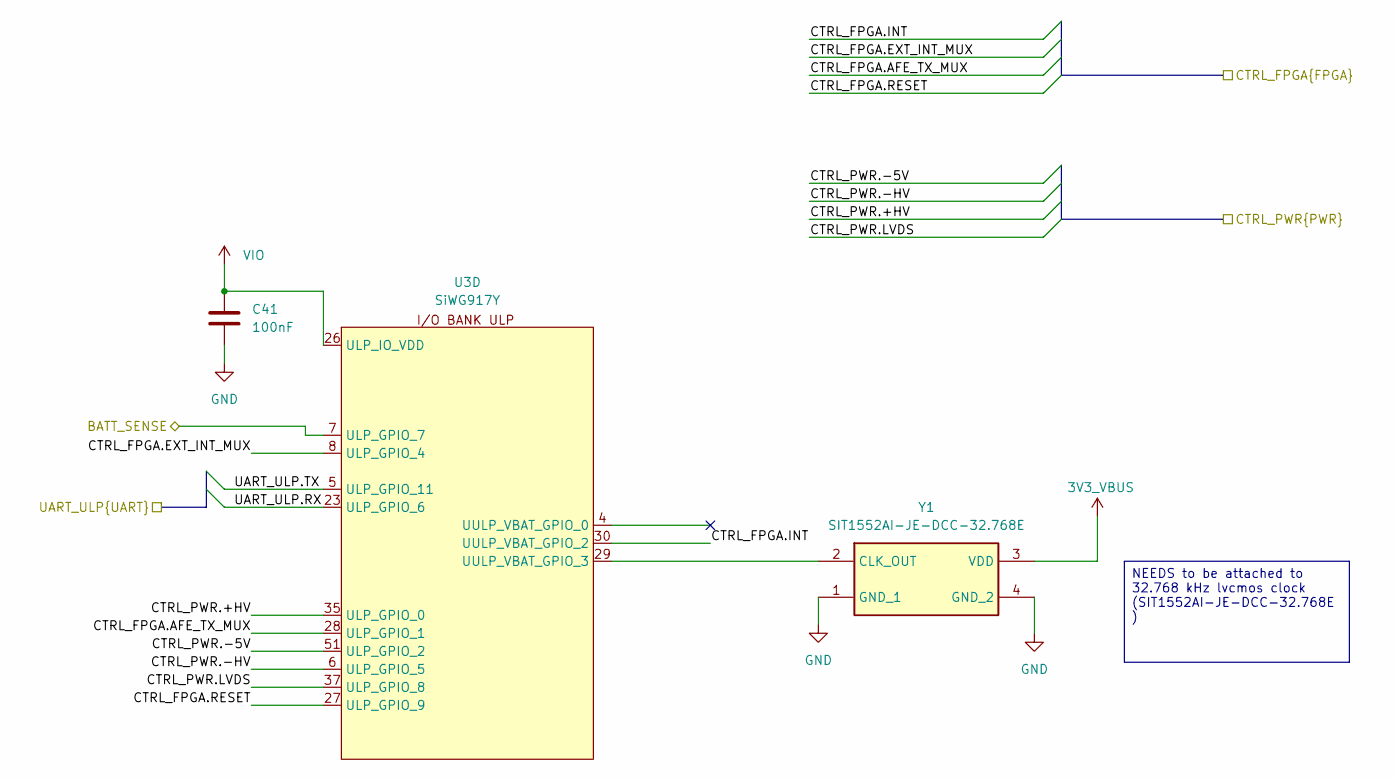
[picture p32: schematic MCU_ULP_IO.kicad_sch]

Parts:
C41: 100nF; C_0201_0603Metric; Voltage 10V; Tolerance 20%; MPN GRM033R61A104ME15
U3: SiWG917Y; Voltage 3.0V-3.63V; MPN SiWG917Y
Y1: SIT1552AI-JE-DCC-32.768E; SIT1552AIJEDCC32768E; MPN SIT1552AI-JE-DCC-32.768E; LCSC C7464055

Connections:
3V3_VBUS: Y1.3 (VDD); also elsewhere on the board
/DEBUG, RESET & POC_IN, PROGRAMMING INTERFACE/UART_ULP.RX: U3.23 (ULP_GPIO_6); also elsewhere on the board
/DEBUG, RESET & POC_IN, PROGRAMMING INTERFACE/UART_ULP.TX: U3.5 (ULP_GPIO_11); also elsewhere on the board
/MCU/BATT_SENSE: U3.7 (ULP_GPIO_7); also elsewhere on the board
/MCU/CTRL_FPGA.AFE_TX_MUX: U3.28 (ULP_GPIO_1); also elsewhere on the board
/MCU/CTRL_FPGA.EXT_INT_MUX: U3.8 (ULP_GPIO_4); also elsewhere on the board
/MCU/CTRL_FPGA.INT: U3.30 (UULP_VBAT_GPIO_2); also elsewhere on the board
/MCU/CTRL_FPGA.RESET: U3.27 (ULP_GPIO_9); also elsewhere on the board
/MCU/CTRL_PWR.+HV: U3.35 (ULP_GPIO_0); also elsewhere on the board
/MCU/CTRL_PWR.-5V: U3.51 (ULP_GPIO_2); also elsewhere on the board
/MCU/CTRL_PWR.-HV: U3.6 (ULP_GPIO_5); also elsewhere on the board
/MCU/CTRL_PWR.LVDS: U3.37 (ULP_GPIO_8); also elsewhere on the board
GND: C41.2, Y1.1 (GND_1), Y1.4 (GND_2); also elsewhere on the board
unnamed: U3.29 (UULP_VBAT_GPIO_3), Y1.2 (CLK_OUT)
VIO: C41.1, U3.26 (ULP_IO_VDD); also elsewhere on the board

Notes on the sheet:
NEEDS to be attached to 32.768 kHz lvcmos clock (SIT1552AI-JE-DCC-32.768E )

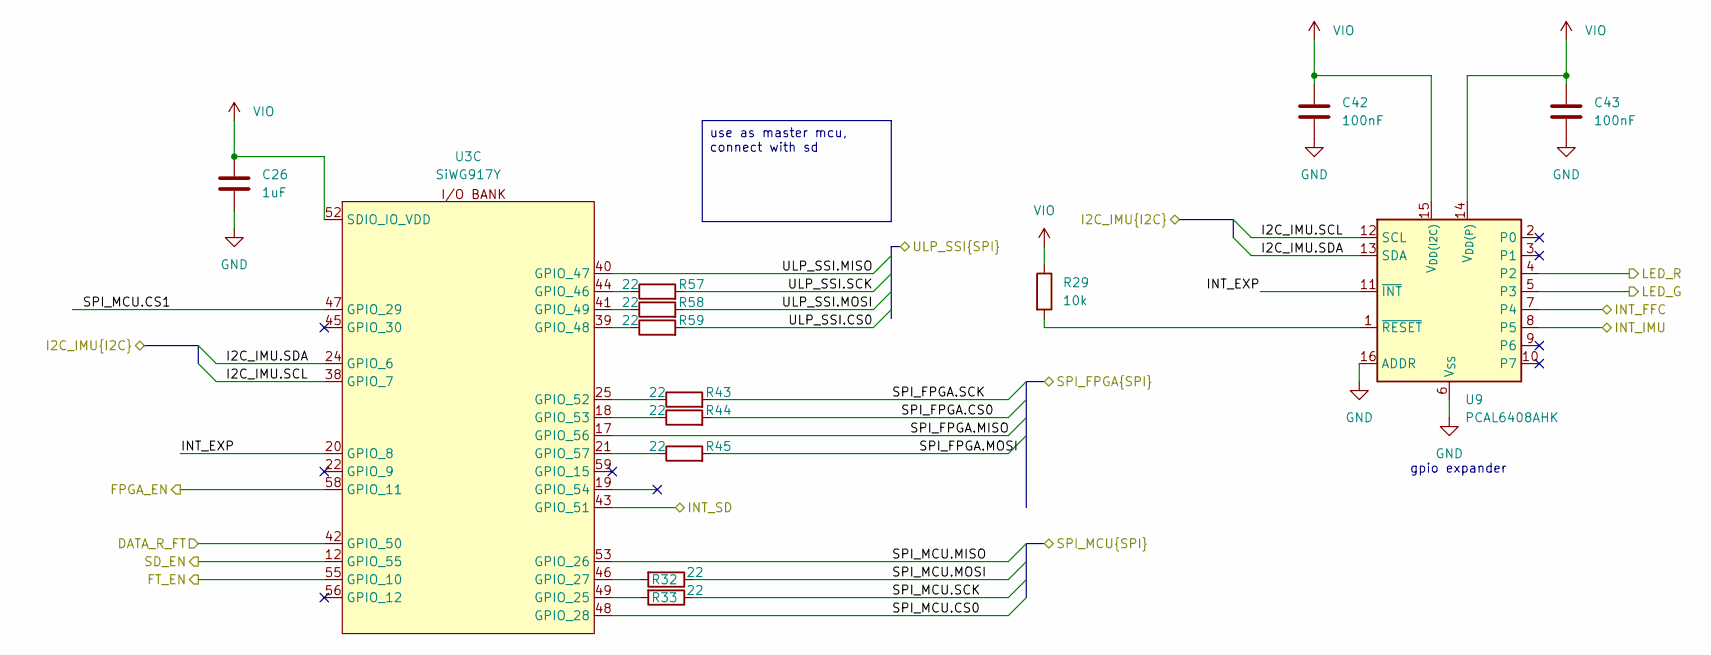
[picture p33: schematic mcu_io.kicad_sch]

Parts:
C26: 1uF; C_0402_1005Metric; Voltage 16V; Tolerance 20%; MPN GRM155R61C105MA12; LCSC C77009
C42, C43: 100nF; C_0201_0603Metric; Voltage 10V; Tolerance 20%; MPN GRM033R61A104ME15
R29: 10k; R_0402_1005Metric; Tolerance 1%; MPN ERJ-2RKF1002X; LCSC C191123
R32, R33: 22; R_0402_1005Metric; Tolerance 1%; MPN ERJ-2RKF22R0X; LCSC C413049
R43, R44, R45, R57, R58, R59: 22; R_0201_0603Metric; Tolerance 1%; MPN ERJ-1GJF22R0C; LCSC C20021234
U3: SiWG917Y; Voltage 3.0V-3.63V; MPN SiWG917Y
U9: PCAL6408AHK; UQFN-16_1.8x2.6mm_P0.4mm; MPN PCAL6408AHK; LCSC C5203525

Connections:
/DEBUG, RESET & POC_IN, PROGRAMMING INTERFACE/LED_G: U9.5 (P3); also elsewhere on the board
/DEBUG, RESET & POC_IN, PROGRAMMING INTERFACE/LED_R: U9.4 (P2); also elsewhere on the board
/IMU_SD/I2C_IMU.SCL: U3.38 (GPIO_7), U9.12 (SCL); also elsewhere on the board
/IMU_SD/I2C_IMU.SDA: U3.24 (GPIO_6), U9.13 (SDA); also elsewhere on the board
/IMU_SD/INT_IMU: U9.8 (P5); also elsewhere on the board
/IMU_SD/INT_SD: U3.43 (GPIO_51); also elsewhere on the board
/IMU_SD/SD_EN: U3.12 (GPIO_55); also elsewhere on the board
/IMU_SD/SPI_MCU.CS0: U3.48 (GPIO_28); also elsewhere on the board
/IMU_SD/SPI_MCU.CS1: U3.47 (GPIO_29); also elsewhere on the board
/IMU_SD/SPI_MCU.MISO: U3.53 (GPIO_26); also elsewhere on the board
/IMU_SD/SPI_MCU.MOSI: R32.1; also elsewhere on the board
/IMU_SD/SPI_MCU.SCK: R33.1; also elsewhere on the board
/MCU/DATA_R_FT: U3.42 (GPIO_50); also elsewhere on the board
/MCU/FPGA_EN: U3.58 (GPIO_11); also elsewhere on the board
/MCU/FT_EN: U3.55 (GPIO_10); also elsewhere on the board
/MCU/INT_FFC: U9.7 (P4); also elsewhere on the board
/MCU/MCU_IO/INT_EXP: U3.20 (GPIO_8), U9.11 (~INT)
/MCU/SPI_FPGA.CS0: R44.2; also elsewhere on the board
/MCU/SPI_FPGA.MISO: U3.17 (GPIO_56); also elsewhere on the board
/MCU/SPI_FPGA.MOSI: R45.2; also elsewhere on the board
/MCU/SPI_FPGA.SCK: R43.2; also elsewhere on the board
/MCU/ULP_SSI.CS0: R59.2; also elsewhere on the board
/MCU/ULP_SSI.MISO: U3.40 (GPIO_47); also elsewhere on the board
/MCU/ULP_SSI.MOSI: R58.2; also elsewhere on the board
/MCU/ULP_SSI.SCK: R57.2; also elsewhere on the board
GND: C26.2, C42.2, C43.2, U9.6 (V_{SS}), U9.16 (ADDR); also elsewhere on the board
unnamed: R33.2, U3.49 (GPIO_25)
unnamed: R32.2, U3.46 (GPIO_27)
unnamed: R57.1, U3.44 (GPIO_46)
unnamed: R59.1, U3.39 (GPIO_48)
unnamed: R58.1, U3.41 (GPIO_49)
unnamed: R43.1, U3.25 (GPIO_52)
unnamed: R44.1, U3.18 (GPIO_53)
unnamed: R45.1, U3.21 (GPIO_57)
unnamed: R29.2, U9.1 (~RESET)
VIO: C26.1, C42.1, C43.1, R29.1, U3.52 (SDIO_IO_VDD), U9.14 (V_{DD(P)}), U9.15 (V_{DD(I2C)}); also elsewhere on the board

Notes on the sheet:
gpio expander
use as master mcu, connect with sd

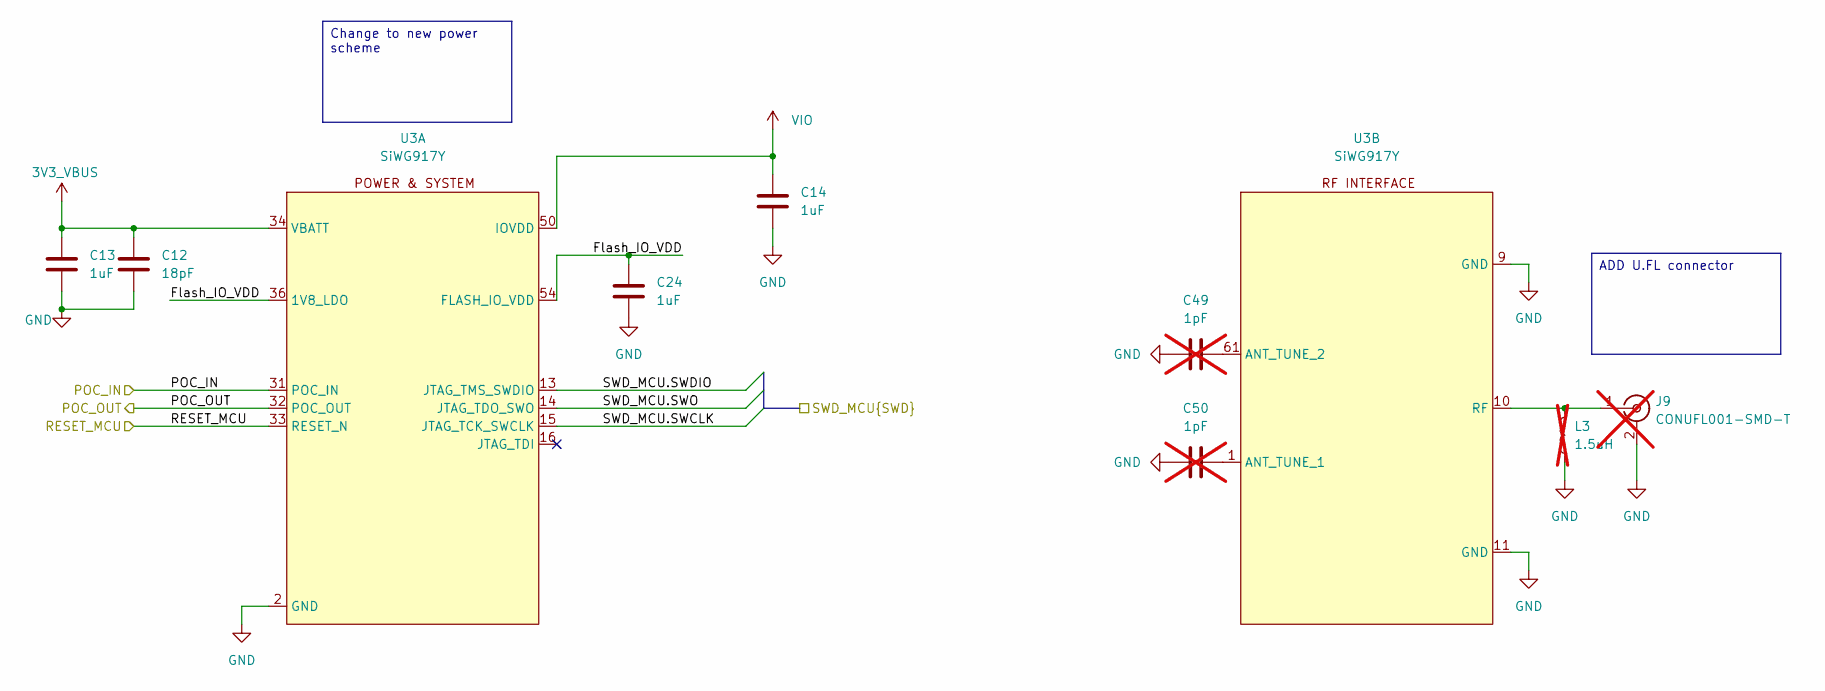
[picture p34: schematic mcu_power.kicad_sch]

Parts:
C12: 18pF; C_0402_1005Metric; Tolerance 5%; Voltage 50V; MPN GRM1555C1H180JA01; LCSC C33149
C13, C14, C24: 1uF; C_0402_1005Metric; Voltage 16V; Tolerance 20%; MPN GRM155R61C105MA12; LCSC C77009
C49, C50: 1pF; C_0402_1005Metric; Voltage 50V; Tolerance ±0.25pF; MPN GRM1555C1H1R0CA01; LCSC C76953; not fitted
J9: U.FL; U.FL_Hirose_U.FL-R-SMT-1_Vertical; MPN CONUFL001-SMD-T; LCSC C41432122; not fitted
L3: 1.5uH; L_0805_2012Metric; MPN 0805LS-152GRC; LCSC C40455103; not fitted
U3: SiWG917Y; Voltage 3.0V-3.63V; MPN SiWG917Y

Connections:
3V3_VBUS: C12.1, C13.1, U3.34 (VBATT); also elsewhere on the board
/DEBUG, RESET & POC_IN, PROGRAMMING INTERFACE/SWD_MCU.SWCLK: U3.15 (JTAG_TCK_SWCLK); also elsewhere on the board
/DEBUG, RESET & POC_IN, PROGRAMMING INTERFACE/SWD_MCU.SWDIO: U3.13 (JTAG_TMS_SWDIO); also elsewhere on the board
/DEBUG, RESET & POC_IN, PROGRAMMING INTERFACE/SWD_MCU.SWO: U3.14 (JTAG_TDO_SWO); also elsewhere on the board
/MCU/MCU_POWER_RF/Flash_IO_VDD: C24.1, U3.36 (1V8_LDO), U3.54 (FLASH_IO_VDD)
/MCU/MCU_POWER_RF/POC_IN: U3.31 (POC_IN); also elsewhere on the board
/MCU/MCU_POWER_RF/POC_OUT: U3.32 (POC_OUT); also elsewhere on the board
/MCU/MCU_POWER_RF/RESET_MCU: U3.33 (RESET_N); also elsewhere on the board
GND: C12.2, C13.2, C14.2, C24.2, C49.1, C50.1, J9.2 (Ext), L3.1, U3.2 (GND), U3.3 (GND), U3.9 (GND), U3.11 (GND), U3.57 (GND), U3.60 (GND), U3.62 (GND), U3.63 (GND), U3.64 (GND), U3.65 (GND), U3.66 (GND), U3.67 (GND), U3.68 (GND), U3.69 (GND), U3.70 (GND), U3.71 (GND); also elsewhere on the board
unnamed: J9.1 (In), L3.2, U3.10 (RF)
unnamed: C50.2, U3.1 (ANT_TUNE_1)
unnamed: C49.2, U3.61 (ANT_TUNE_2)
VIO: C14.1, U3.50 (IOVDD); also elsewhere on the board

Notes on the sheet:
Change to new power scheme
ADD U.FL connector

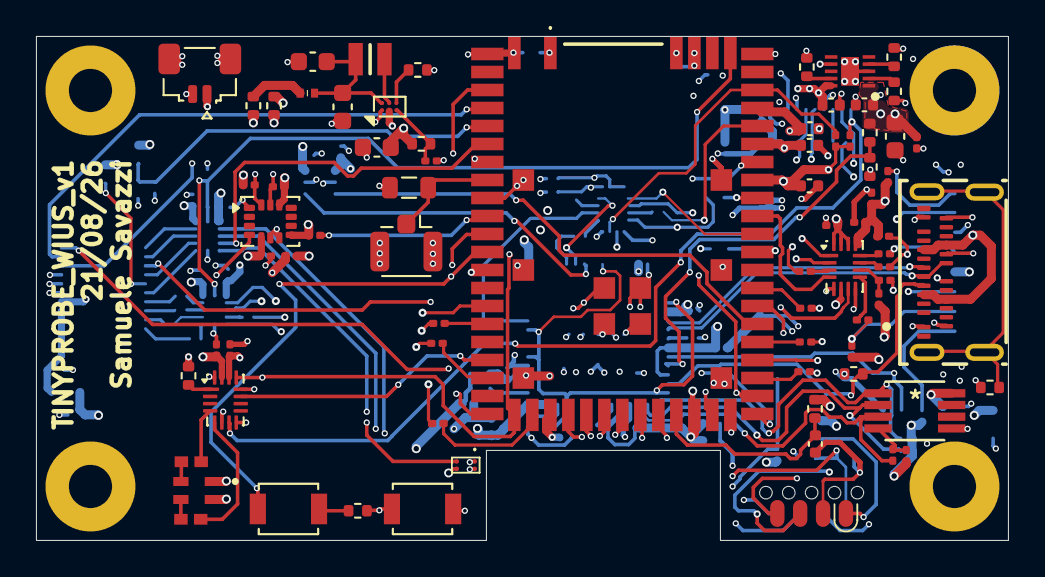
[picture p35: board wius_new.kicad_pcb from above]

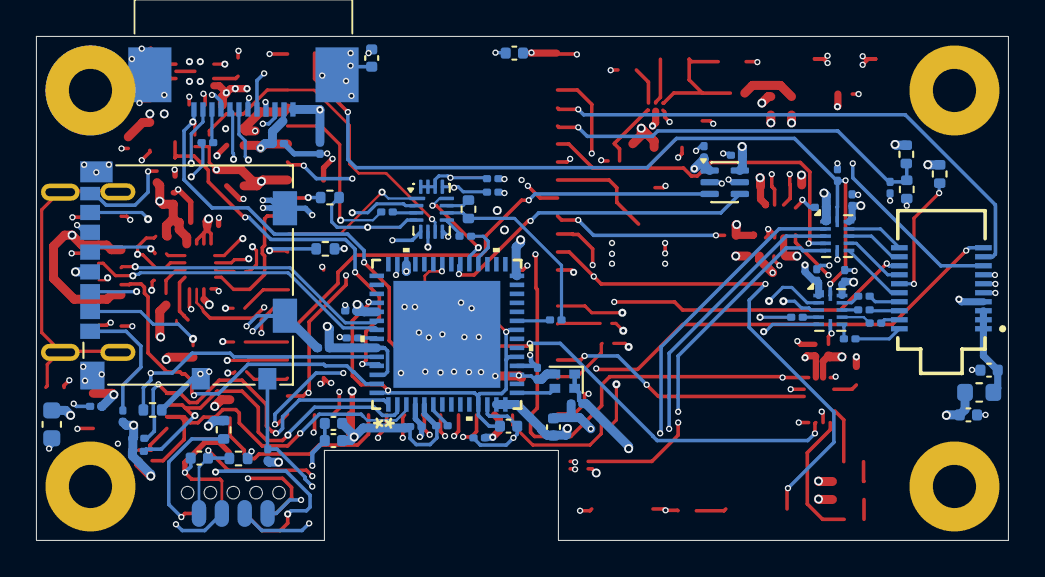
[picture p36: board wius_new.kicad_pcb from below]

Board: 6 copper layers, 54.0 x 28.0 mm, 142 parts (63 on the bottom side), 122 nets.
