ssavazzi02/tinyProbe_wius/(commit log)

2026-06-05 Inizializzazione progetto wearable: configurazione base KiCad e .gitignore
    [Peripherals.kicad_sch, Power.kicad_sch, Power_&_USB.kicad_sch, connectors.kicad_sch, gap.kicad_sch, io.kicad_sch, mcu.kicad_sch, mcu_io.kicad_sch]
2026-06-05 Rimossa definitivamente la cartella dei backup dal server
2026-06-11 insert of gpio expander
    [MCU_ULP_IO.kicad_sch, PCAL6408AHKX.stp, mcu.kicad_sch, mcu_io.kicad_sch, wius_new.kicad_sch]
2026-06-12 added schematics comments of review 1
    [MCU_ULP_IO.kicad_sch, Peripherals.kicad_sch, Power_&_USB.kicad_sch, connectors.kicad_sch, gap.kicad_sch, mcu.kicad_sch, mcu_io.kicad_sch, mcu_power.kicad_sch]
2026-06-18 changes after first review: add lvl shifters, board at 1v8, new power tree
    [MCU_ULP_IO.kicad_sch, Peripherals.kicad_sch, Power_&_USB.kicad_sch, connectors.kicad_sch, debug_interface.kicad_sch, gap.kicad_sch, mcu.kicad_sch, mcu_io.kicad_sch]
2026-06-25 updated schematic and initial pcb placement
    [MCU_ULP_IO.kicad_sch, Peripherals.kicad_sch, Power_&_USB.kicad_sch, connectors.kicad_sch, debug_interface.kicad_sch, mcu.kicad_sch, mcu_io.kicad_sch, power_conv.kicad_sch]
2026-06-25 upload of 3d models used in pcb document
    [104031-0811.stp, 1040310811.stp, 5051100892.stp, 52746-1271.stp, ASMPM-0806-2R2M-T.STEP, BQ24040DSQT.stp, QFN-56_FT232HPQ_FTD.step, SIT1552AI-JE-DCC-32.768E.stp]
2026-07-07 new debug connector SOICbite, new board shape, new placement, addition of 22 ohm resistance in fast digital signals as spi
    [Peripherals.kicad_sch, Power_&_USB.kicad_sch, connectors.kicad_sch, debug_interface.kicad_sch, mcu_io.kicad_sch, wius_new.kicad_pcb, wius_placement_1.kicad_pcb]
2026-07-13 Add comments from layout meeting 13.07.2026
    [wius_new.kicad_pcb]
2026-07-17 initial routing of SPI, USB and Power
    [Peripherals.kicad_sch, Power_&_USB.kicad_sch, wius_new.kicad_pcb]
2026-07-17 Comments on layout
    [MCU_ULP_IO.kicad_sch, Peripherals.kicad_sch, Power_&_USB.kicad_sch, connectors.kicad_sch, debug_interface.kicad_sch, mcu.kicad_sch, mcu_io.kicad_sch, mcu_power.kicad_sch]
2026-07-18 updated routing SPI, change 0402 to 0201
    [MCU_ULP_IO.kicad_sch, Peripherals.kicad_sch, Power_&_USB.kicad_sch, connectors.kicad_sch, mcu_io.kicad_sch, power_conv.kicad_sch, wius_new.kicad_pcb]
2026-07-20 Add comments from layout meeting 20.07.2026
    [Peripherals.kicad_sch, Power_&_USB.kicad_sch, mcu_io.kicad_sch, mcu_power.kicad_sch, wius_new.kicad_pcb]
2026-07-21 updated power routing
    [wius_new.kicad_pcb]
2026-07-25 initial power planes
    [wius_new.kicad_pcb]
2026-08-05 updated pcb
    [wius_new.kicad_pcb]
2026-08-09 updated routing
    [Peripherals.kicad_sch, wius_new.kicad_pcb]
2026-08-20 updated eeprom and oscillator
    [ASCO-12.000MHZ-EK-T3.stp, MSOP8_MC_MCH.step, Power_&_USB.kicad_sch, mcu_io.kicad_sch, wius_new.kicad_pcb]
2026-08-20 updated schematic and PCB
    [Power_&_USB.kicad_sch, wius_new.kicad_pcb]
2026-08-21 final v1
    [wius_new.kicad_pcb]
2026-08-25 updated pcb file for rules
    [wius_new.kicad_pcb]
2026-08-25 final v2
    [bom.csv, designators.csv, positions.csv, wius_new.kicad_pcb]
2026-09-01 Fix TPS62840 footprint
    [wius_new.kicad_pcb]
