ssavazzi02/tinyProbe_wius/(notices)

Notices in the files:
3d_model/SS5-10-3.00-L-D-K-TR.stp:
author */ ('License CC BY-ND 4.0'),
